Lesser-M/ECEN404-Team-30--Autonomous-lawnmower/Reports-404/Individual Reports/5-3 404 Schedule.pdf

# Execution Plan for Autonomous Lawnmower

Pink: Presentation Week
Entire system
Final Presentation
Final Demo
Final Report
Obstacle detection construction
Obstacle detection validated
Obstacle detection & GPS MCU validation Obstacle detection & GPS MCU integration Power Supply Testing and Validation Lawnmower Shell Deconstruction Lawnmower Shell Cleaning
Docking Station Data Collection
Docking Station Assembly
Docking Station Testing
Docking Station and Power Supply Integration Docking Station and Power Supply Testing Docking Station/Power Supply System Integration User Interface Bug Fixing
User Interface Integration, Validation
ESP32 MC Setup, Integration, & Validation Navigation subsystem design and testing Navigation subsystem integration
Motors subsystem integration
| Snow storm and power outages. Limited/No ablity to work on project

COLOR LEGEND
Subsystem Construction and Testing Integration
System Validation
Presentations/Reports
1/19/2021 | 1/26/2021 | 2/2/2021 | 2/9/2021 | 2/16/2021 | 2/23/2021 | 3/2/2021 | 3/9/2021 | 3/16/2021 | 3/23/2021 | 3/30/2021 | 4/6/2021 | 4/13/2021 | 4/20/2021 | 4/27/2021
