Lesser-M/ECEN404-Team-30--Autonomous-lawnmower/Presentations&Demos/Presentations/EPS Presentation .pdf

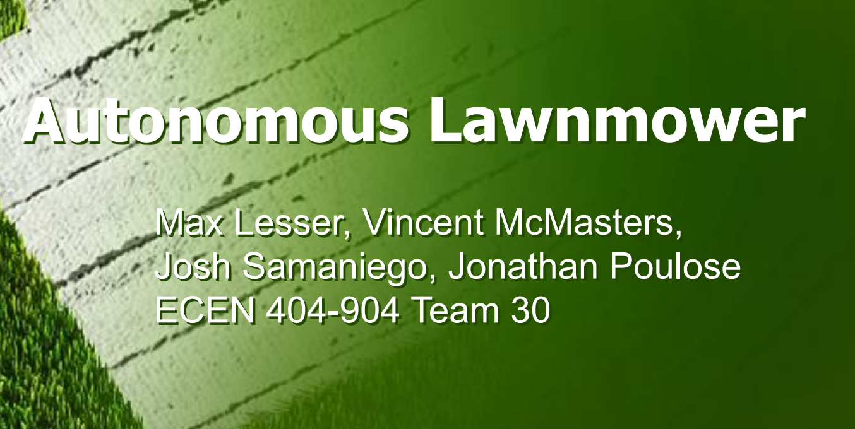
[picture p103: figure]
Autonomous Lawnmower; Max Lesser, Vincent McMasters, Josh Samaniego, Jonathan Poulose ECEN 404-904 Team 30

Project Overview

Problem Statement: “You will start with a lawn mower shell, add motors to propel the wheels, microcontroller to control everything, comms to a wifi network where area to be covered and route will be entered, and a power mechanism (docking station or other)” -
Sponsored by Prof Kalafatis

Solution approach : “We took a used lawn mower, stripped it of all its original parts, mounted motors, wheels, controllers, and sensors. We encountered many mechanical problems and had to rebuild large parts of the project in very short time, so sadly we did not get as far as we had hoped”

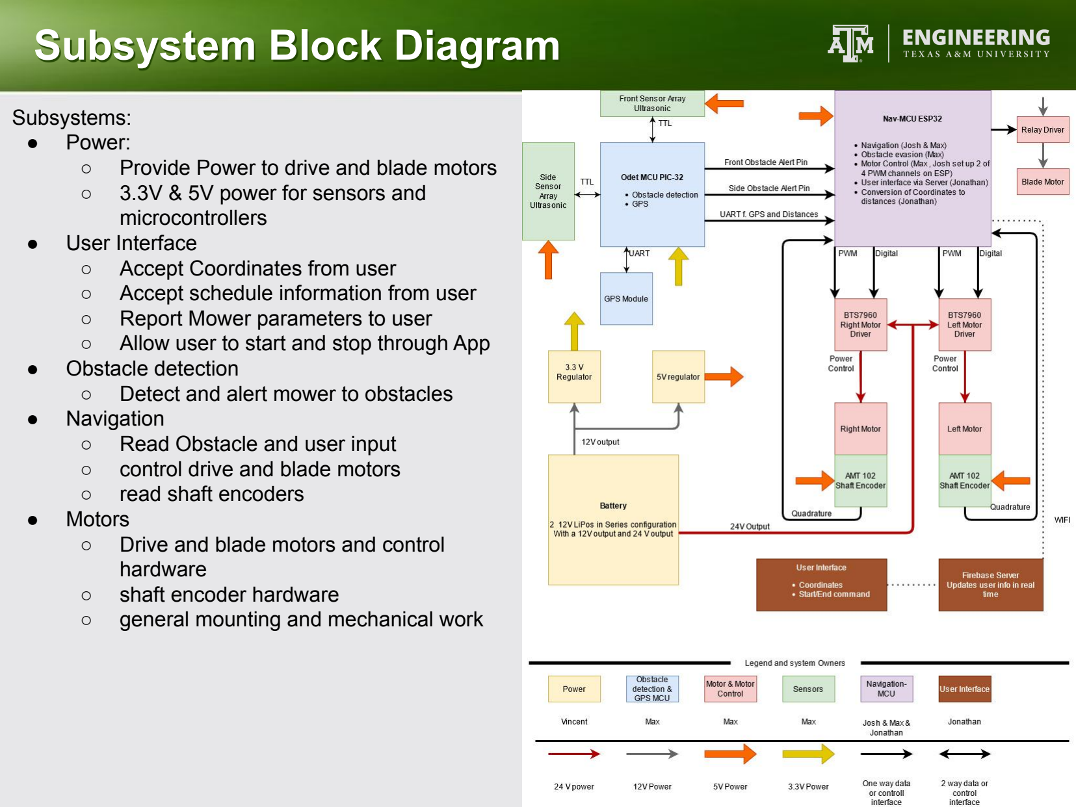
[picture p104: page 3]

Subsystem Block Diagram

Subsystems:
- Power:
- Provide Power to drive and blade motors
- 3.3V & 5V power for sensors and microcontrollers
- User Interface
- Accept Coordinates from user
- Accept schedule information from user
- Report Mower parameters to user
- Allow user to start and stop through App
- Obstacle detection
- Detect and alert mower to obstacles
- Navigation
- Read Obstacle and user input
- control drive and blade motors
- read shaft encoders
- Motors
- Drive and blade motors and control hardware
- shaft encoder hardware
- general mounting and mechanical work

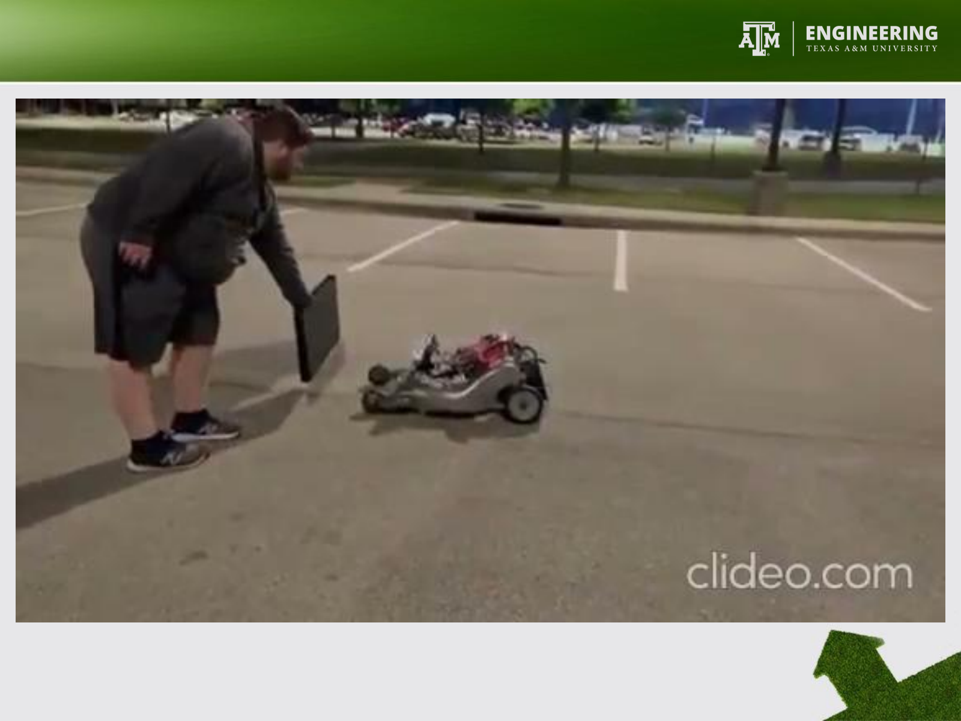
[picture p105: page 4]

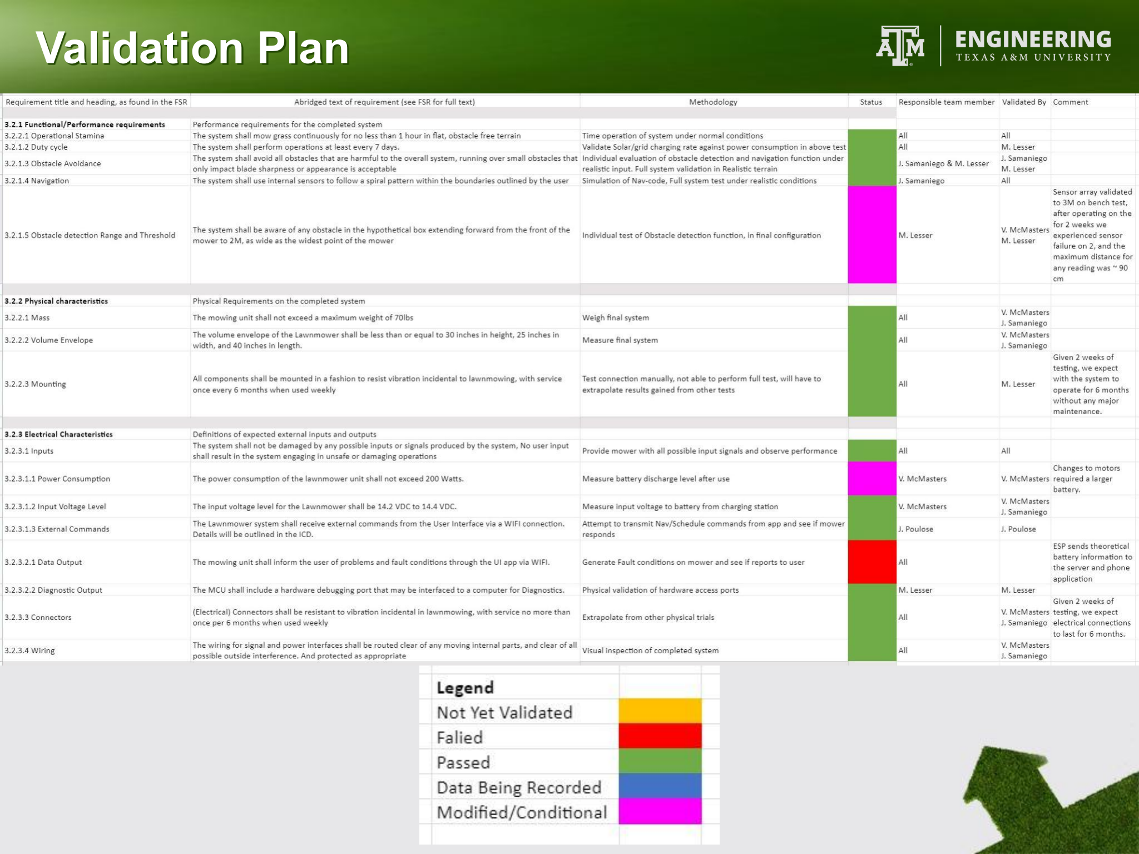
[picture p106: page 7]

Validation Plan

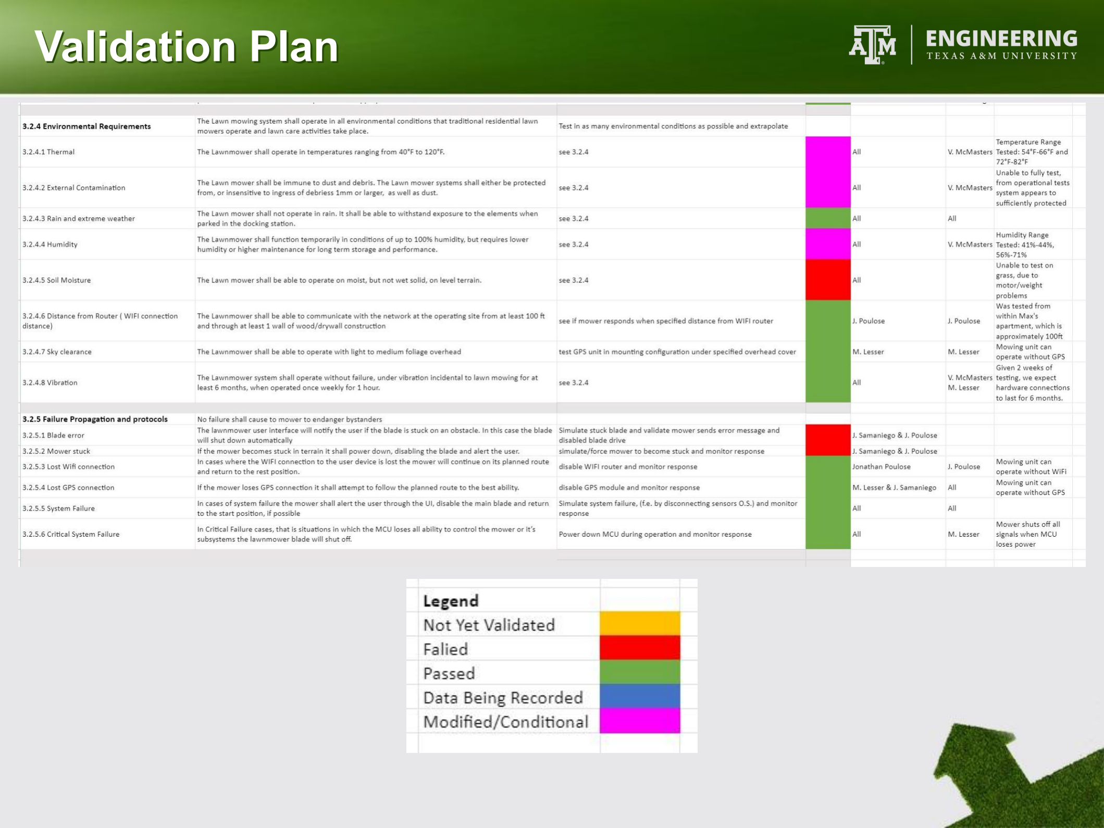
[picture p107: page 8]

Validation Plan

Issues and problems

- Late Changes to Motors
- Late changes to Power system requirements
- Late changes to Navigation system
- Hardware failure for sensors on Circuit boards
- Mechanical complications with mounting

Lessons learned

- Test early, test often
- don’t have faith, validate
- ask for help
- Express clear expectations, and measure progress against them.
- Changing Canoes in the middle of a river is bad, but if you have to, do it before you take on too much water.

Conclusion

Our project came slightly short of the finish line, as we had to address a lot of issues at the very end. Given just marginally more time we believe we could have pulled it all together.

Nonetheless, we all learned a lot. And we’re proud of the progress we’ve made.
