Lesser-M/ECEN404-Team-30--Autonomous-lawnmower/Presentations&Demos/Presentations/Biweekly Presentation 1.pdf

Autonomous Lawnmower; Max Lesser, Vincent McMasters, Josh Samaniego, Jonathan Poulose ECEN 404-904 Team 30

# Project Summary

## Problem Statement: “You will start with a lawn mower shell, add motors to propel the wheels, microcontroller to control everything, comms to a wifi network where area to be covered and route will be entered, and a power mechanism (docking station or other)”

## - Use lawn mower body and reconfigure for our needs - Electric motors for wheel and blade - Solar and grid tied charging - Docking station - Navigate autonomously using various sensors - Receive user information about area to mow and scheduling through app

# Problems and Solutions

## Problems:

- Obstacle detection issues
- Insufficient sensors
- PCB miss print
- Damaged IC
- Insufficient IO lines
- Lost design files
- Low budget

## Solutions:

- Multi MCU approach
- allows multiple team members to develop and test simultaneously
- removes wait time for PCB respin
- Includes all needed functionality
- Shifting responsibility
- Max takes over obstacle detection from sensor subsystem
- Jonathan takes over WIFI from MCU subsystem
- Vincent begins disassembling mower body now, so that it’s integration ready when other subsystems are

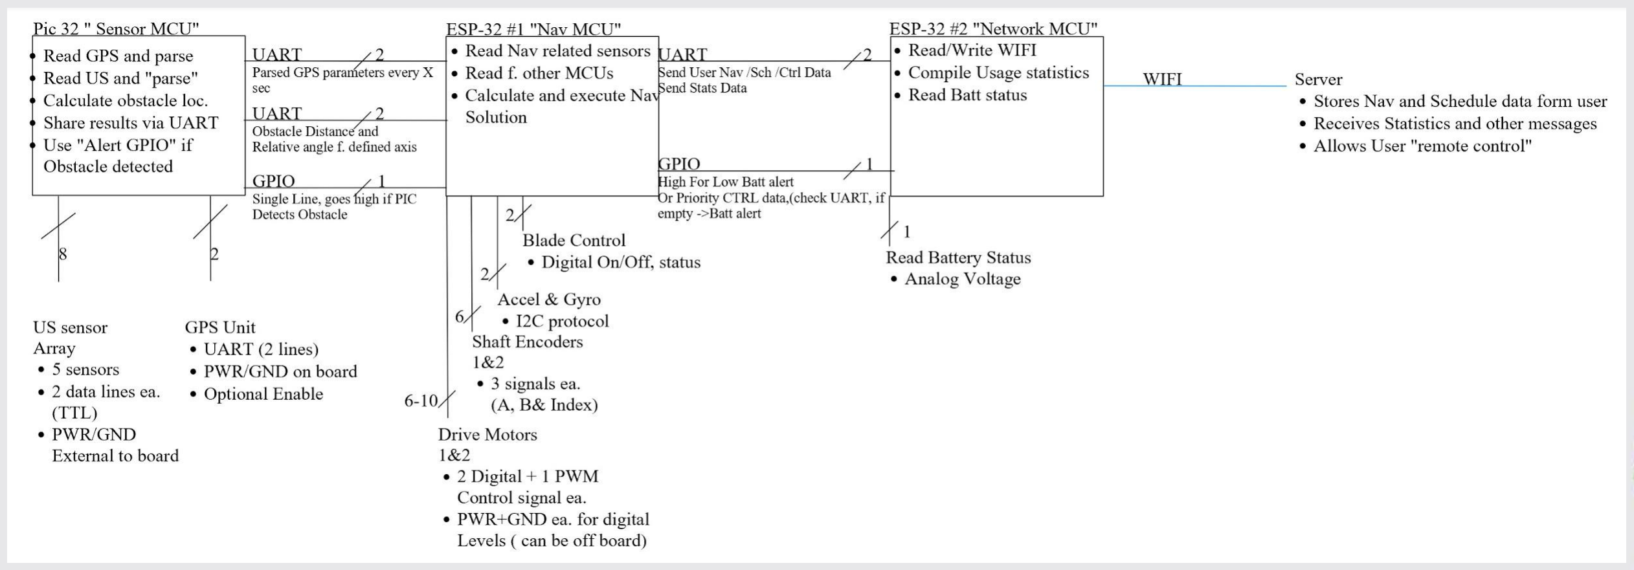
[picture p108: figure]

# MCU Subsystem

# Status and Plans

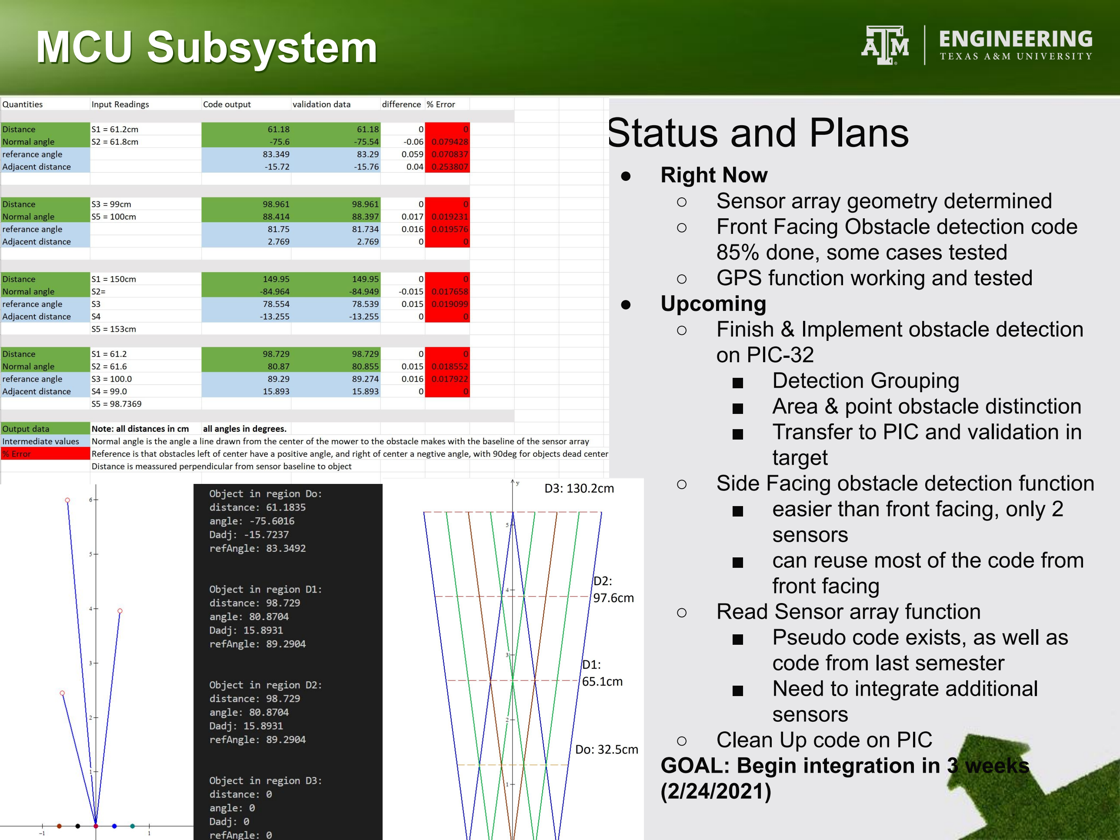
[picture p109: page 4]

- Right Now
- Sensor array geometry determined
- Front Facing Obstacle detection code 85% done, some cases tested
- GPS function working and tested
- Upcoming
- Finish & Implement obstacle detection on PIC-32
■ | Detection Grouping
■ | Area & point obstacle distinction
■ | Transfer to PIC and validation in
| target
- Side Facing obstacle detection function
■ | easier than front facing, only 2
| sensors
■ | can reuse most of the code from
| front facing
- Read Sensor array function
■ | Pseudo code exists, as well as
| code from last semester
■ | Need to integrate additional
| sensors
- Clean Up code on PIC
- GOAL: Begin integration in 3 weeks (2/24/2021)

# User Interface Update

## Android Application

- Coded in Java through android studio
- Updates to server in realtime
- User can login through google account
- Access current location
- Set markers for each corner of lawn
- Custom lawns
- Statistics
- Schedule Information

## Problems-currently fixing

- Bugs
- Getting statistics and scheduling information to communicate with server

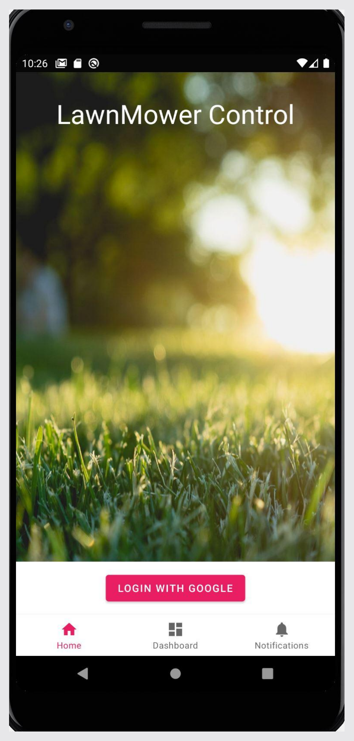
[picture p110: figure]
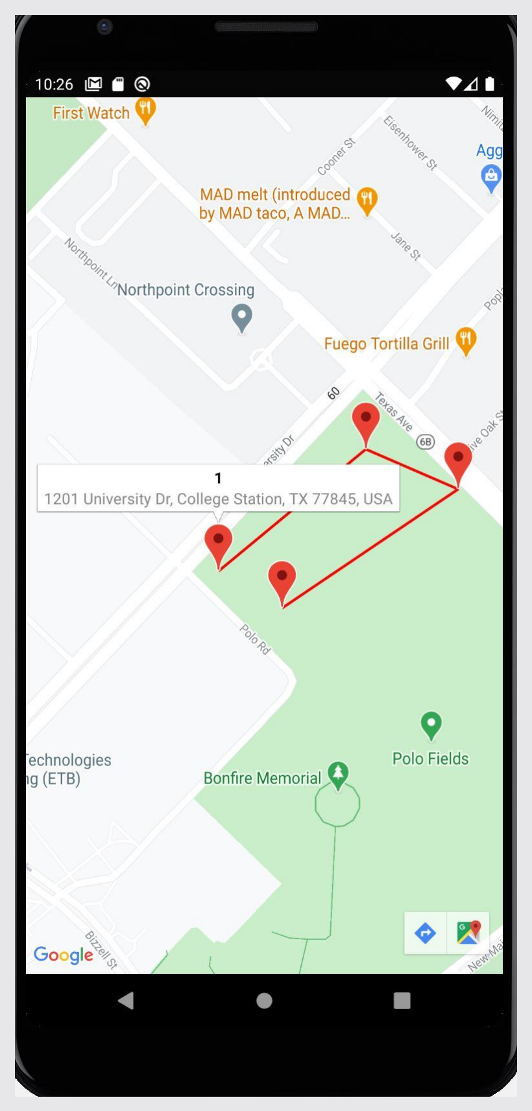
[picture p111: figure]
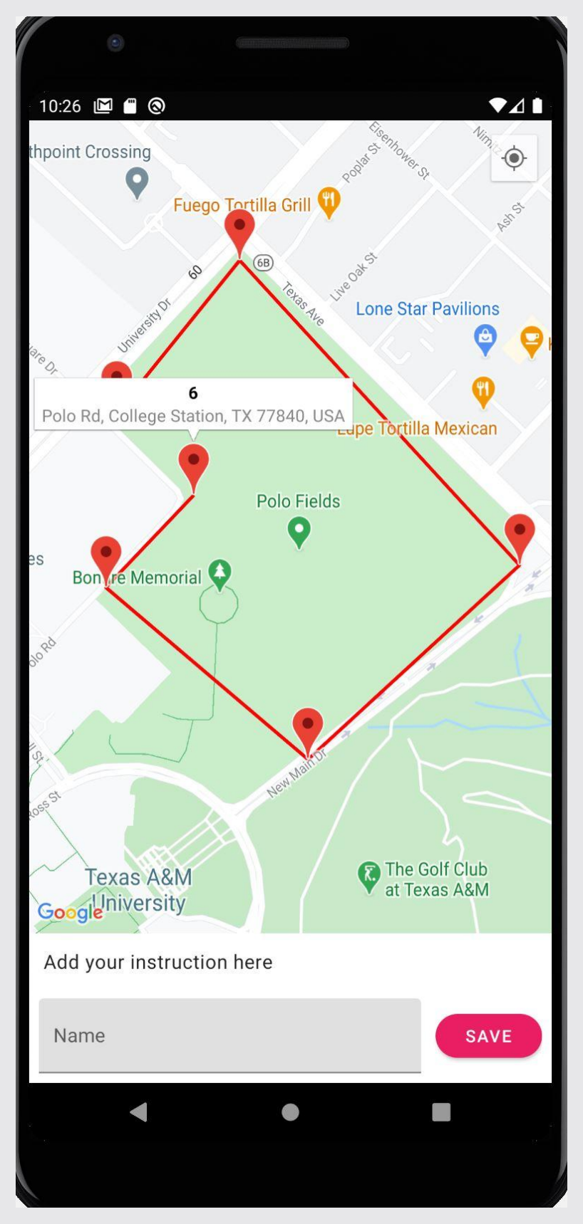
[picture p112: figure]
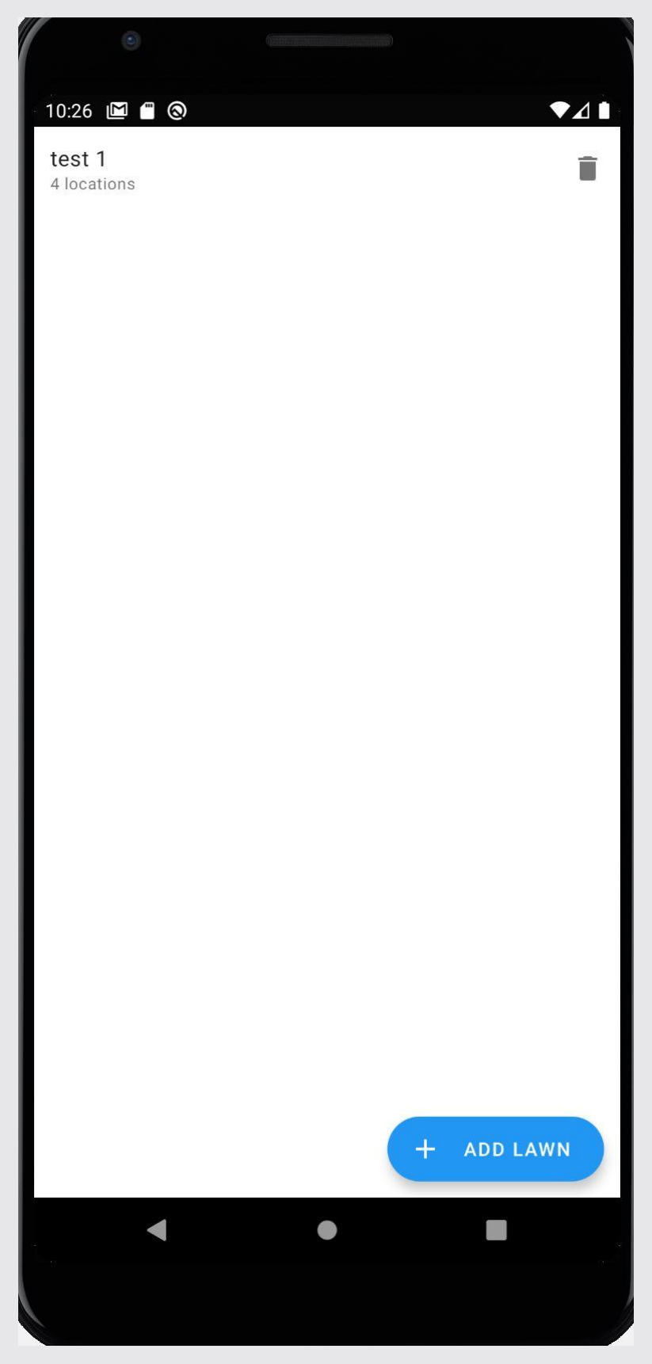
[picture p113: figure]

# Server Update

## Google Firebase Realtime Database

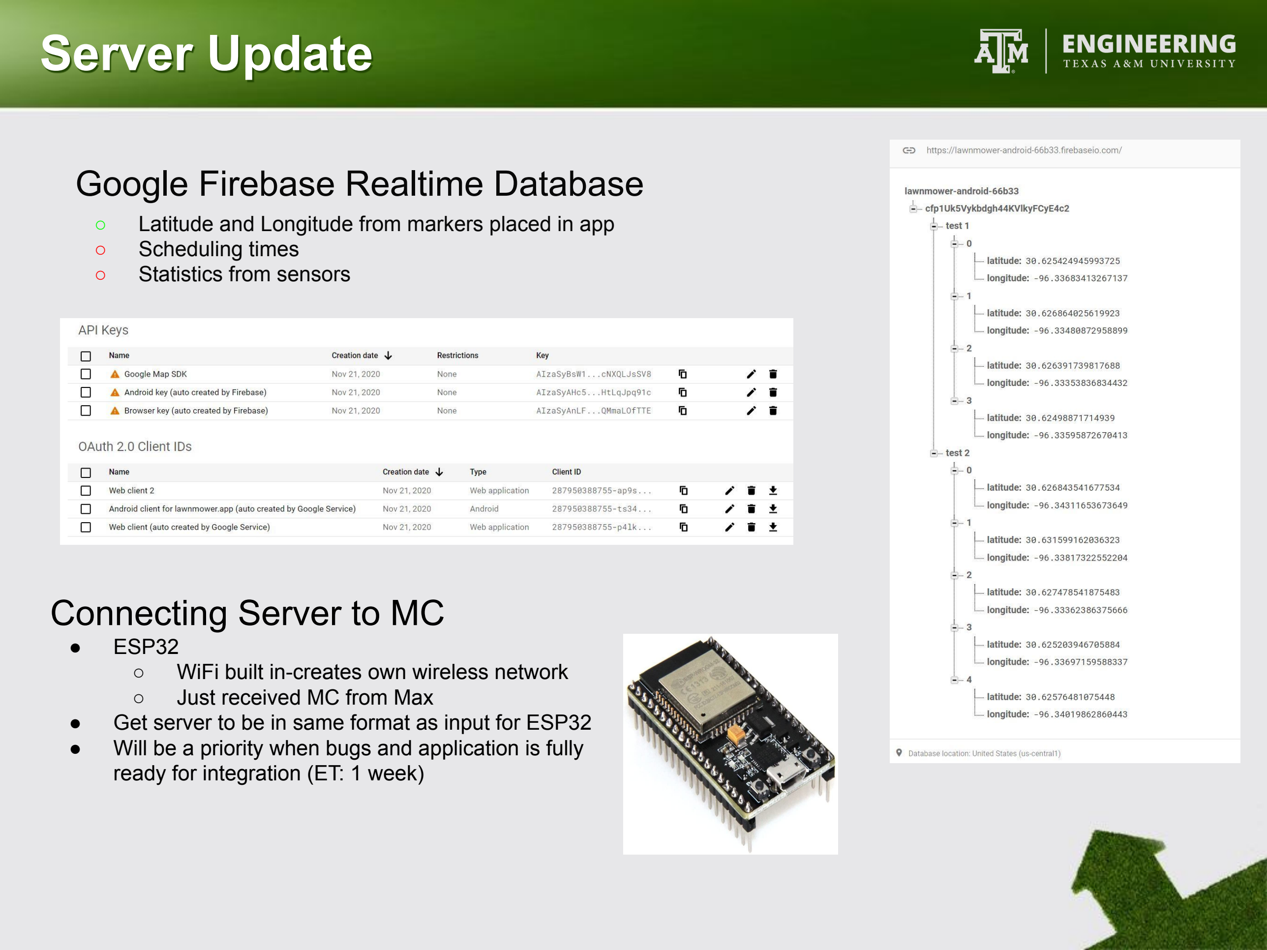
[picture p114: page 6]

- Latitude and Longitude from markers placed in app
- Scheduling times
- Statistics from sensors

## Connecting Server to MC

- ESP32
- WiFi built in-creates own wireless network
- Just received MC from Max
- Get server to be in same format as input for ESP32
- Will be a priority when bugs and application is fully ready for integration (ET: 1 week)

# Power Supply Subsystem Status

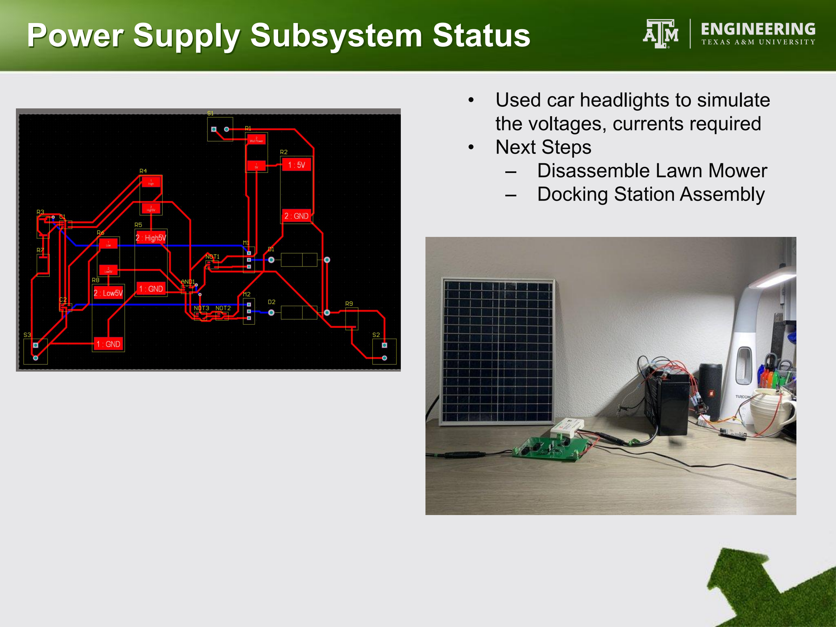
[picture p115: page 7]

### - Used car headlights to simulate the voltages, currents required - Next Steps – Disassemble Lawn Mower – Docking Station Assembly

# Motors Subsystem Status

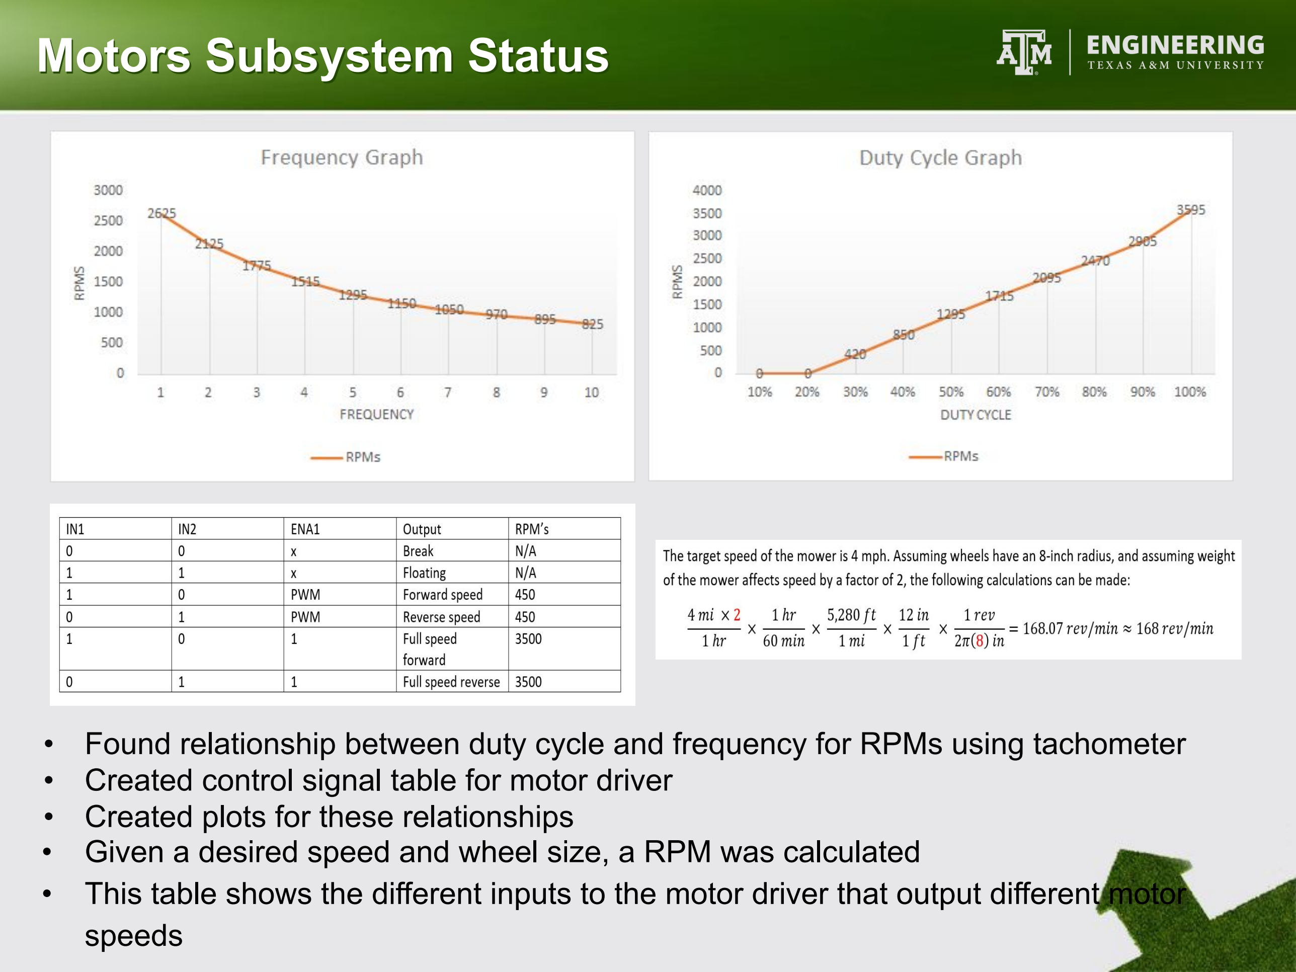
[picture p116: page 8]

- Found relationship between duty cycle and frequency for RPMs using tachometer - Created control signal table for motor driver - Created plots for these relationships - Given a desired speed and wheel size, a RPM was calculated - This table shows the different inputs to the motor driver that output different motor speeds

# Navigation Subsystem Update

## •Original design used GPS module for navigation measurements

## •Testing over the holidays revealed that 10-ft GPS “wander” error is not accurate enough for an “unmanned blade on the run”

## •New design uses individual left and right wheel shaft encoders as primary measurement

## •Some new math was needed to translate the wheel encoder measurements to the correct position and heading of the mower (rigid body constraint)

## •A new Matlab simulation movie will be presented here to demonstrate the recent changes

### Turning is initiated by the controller adjusting the relative speed of the right and left wheel motors

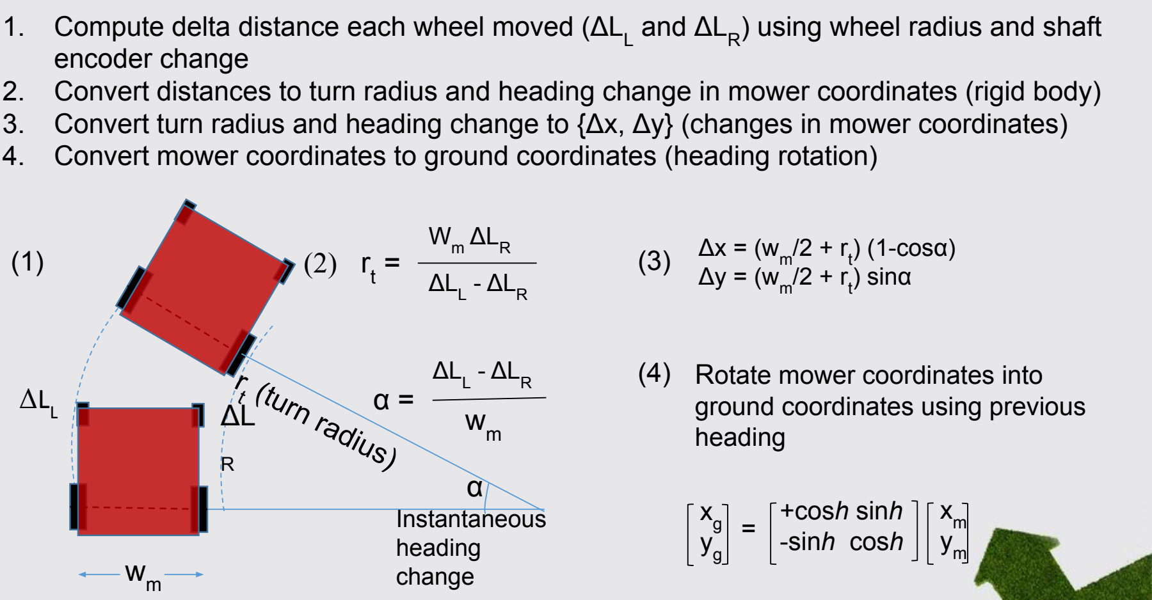
[picture p117: figure]
and ΔLR; ) using wheel radius and shaft; encoder change; ΔLR; ΔLL; - ΔLR; ) (1-cosα); ) sinα (3); (4) Rotate mower coordinates into ground coordinates using previous heading; (turn radius); Instantaneous heading change; +cosh sinh -sinh cosh

### 1. Compute delta distance each wheel moved (ΔLL

### 2. Convert distances to turn radius and heading change in mower coordinates (rigid body) 3. Convert turn radius and heading change to {Δx, Δy} (changes in mower coordinates) 4. Convert mower coordinates to ground coordinates (heading rotation)

# Simulation Updates Using Navigation Updates

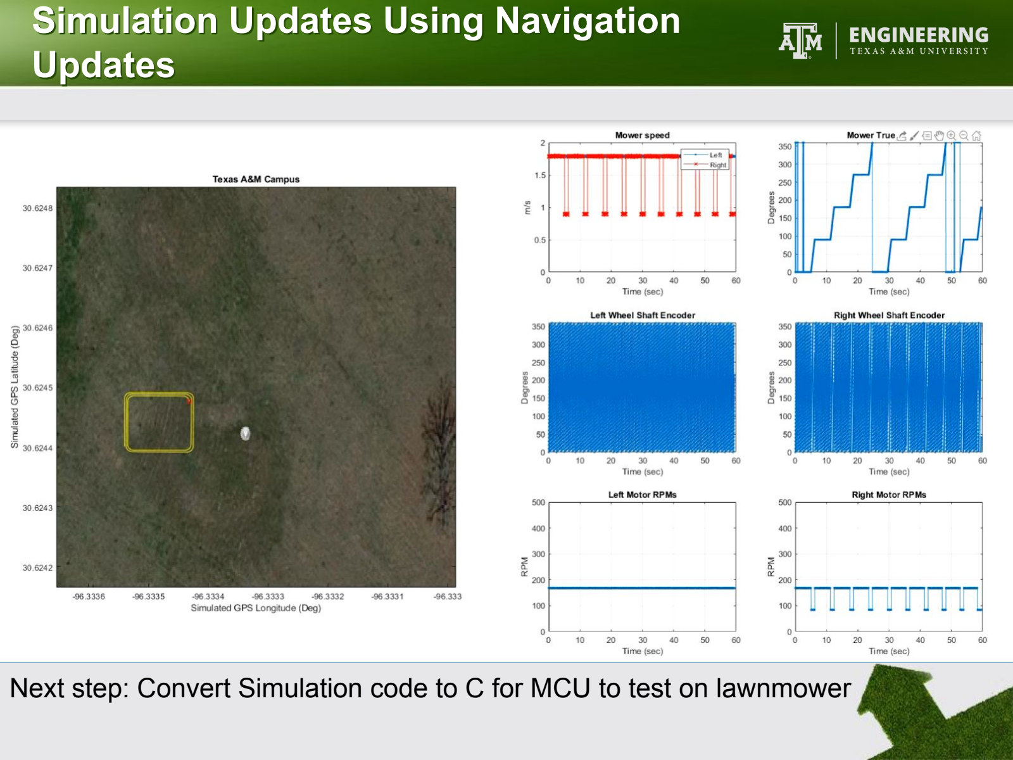
[picture p118: page 11]

## Next step: Convert Simulation code to C for MCU to test on lawnmower

# Schedule for the Semester

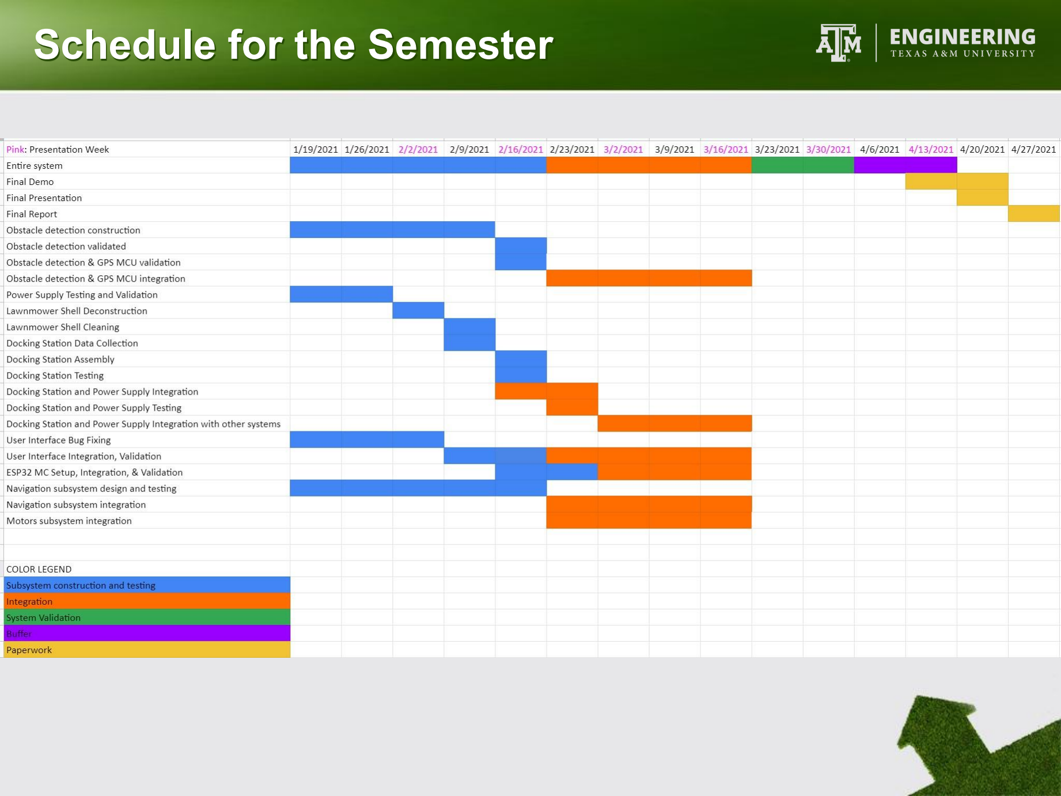
[picture p119: page 12]

# Validation Plan

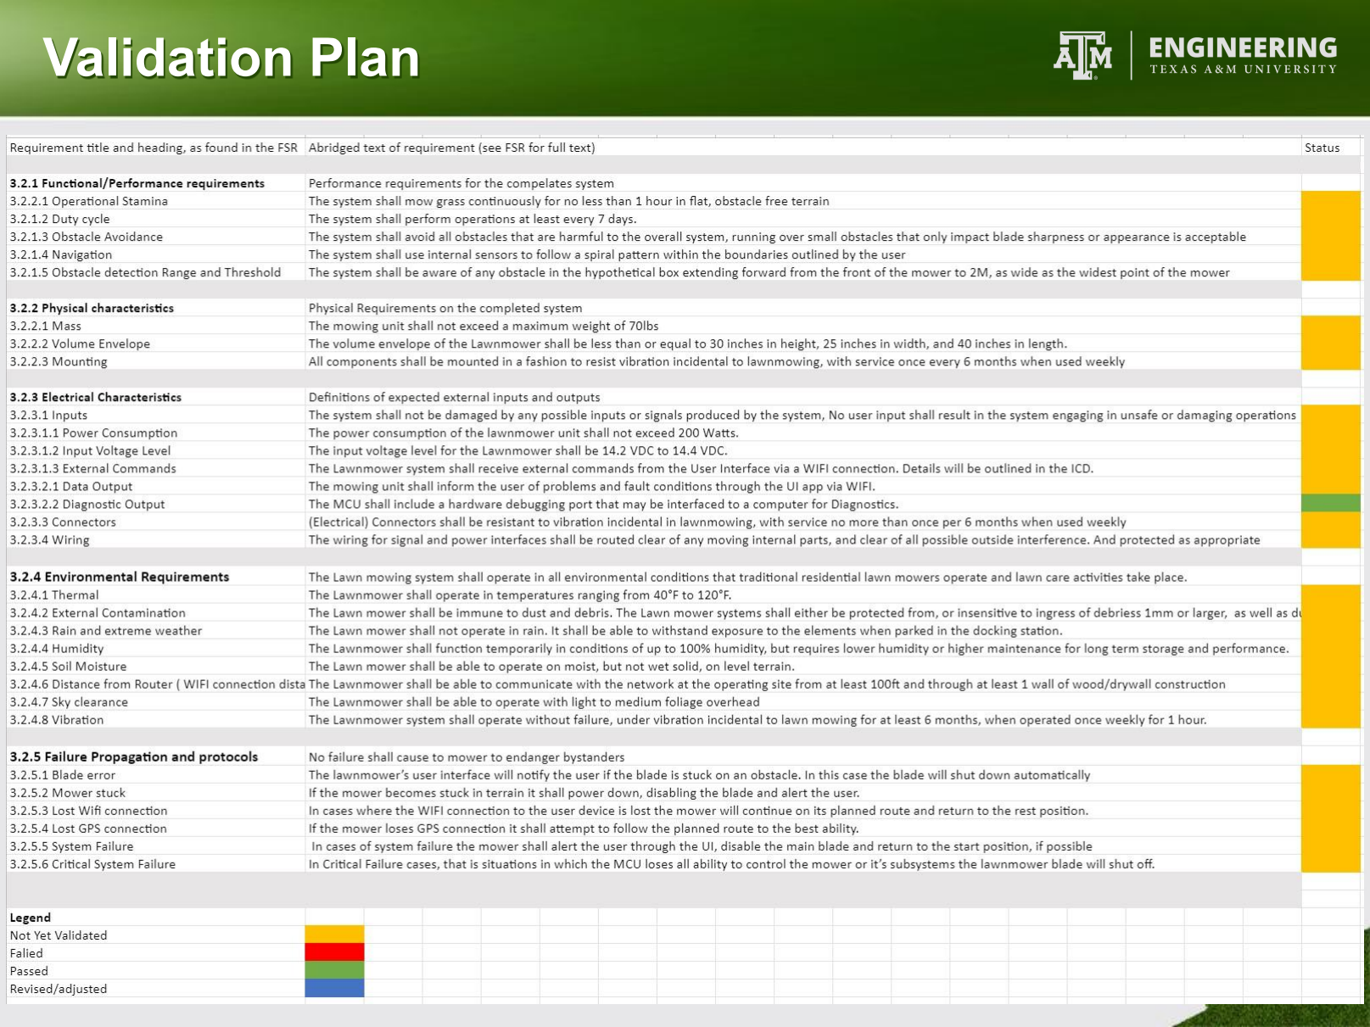
[picture p120: page 13]
