Lesser-M/ECEN404-Team-30--Autonomous-lawnmower/Presentations&Demos/Presentations/Biweekly Presentation 2.pdf

Autonomous Lawnmower; Max Lesser, Vincent McMasters, Josh Samaniego, Jonathan Poulose ECEN 404-904 Team 30

# Project Summary

## Problem Statement: “You will start with a lawn mower shell, add motors to propel the wheels, microcontroller to control everything, comms to a wifi network where area to be covered and route will be entered, and a power mechanism (docking station or other)”

## - Use lawn mower body and reconfigure for our needs - Electric motors for wheel and blade - Solar and grid tied charging - Docking station - Navigate autonomously using various sensors - Receive user information about area to mow and scheduling through app

# Problems and Solutions

## Problems (looking towards interfacing):

- Front Mower wheels 0-degree turn
- Rear Mower wheels
- Geared connection/transmission
- Solid axle
- Blade drive attachment
- How to mount blade motor
- MCU interface
- US sensors have issues detecting object with fabric
- Readings for objects covered in fabric (f.e. person wearing sweatshirt) extremely inaccurate and unreliable

## Solutions:

- Caster wheels in the front
- Allows 0-degree turn
- Several Options for rear
- Cut axel in 2 parts and mount motors to that, adjust for gearing ratio in code
- Manufacture shaft and mount directly to wheels and motors for 1:1 ratio. (Need to ensure sufficient torque, but ratio stays the same, possibly easier motor mounting because the old shaft won’t be in the way)
- Several Options for Blade also
- Disassemble motor and reuse its driveshaft
- Manufacture our own driveshaft
- MCU interface
- Need to finalize format
- Person detection
- Include Bump/contact sensor in front
- More extensive tests with full array, may be possible to determine fabric with multiple sensors.

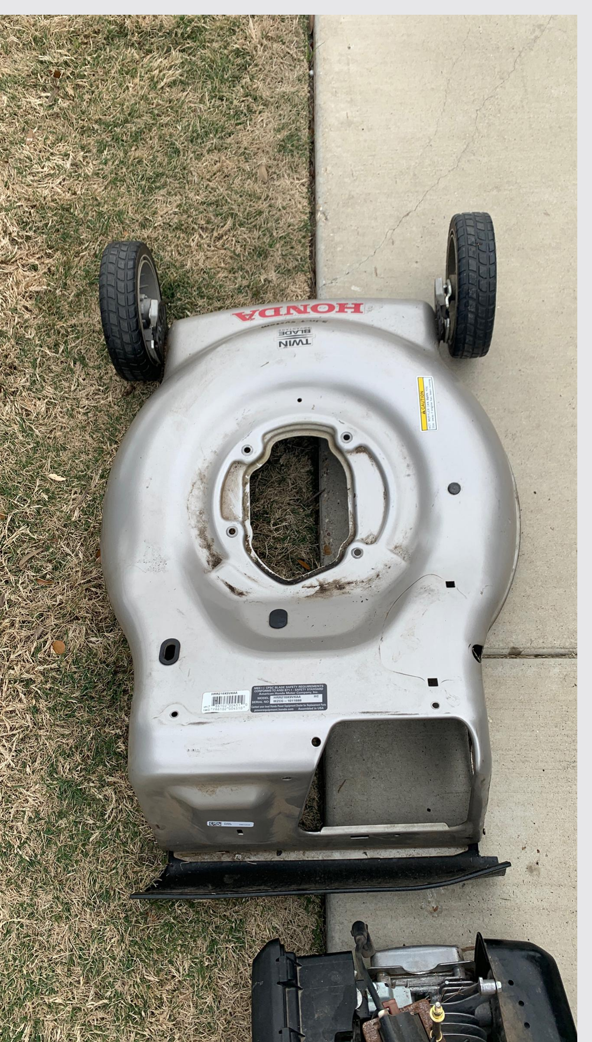
[picture p121: figure]

# MCU Subsystem (Obstacle detection)

# Status and Plans

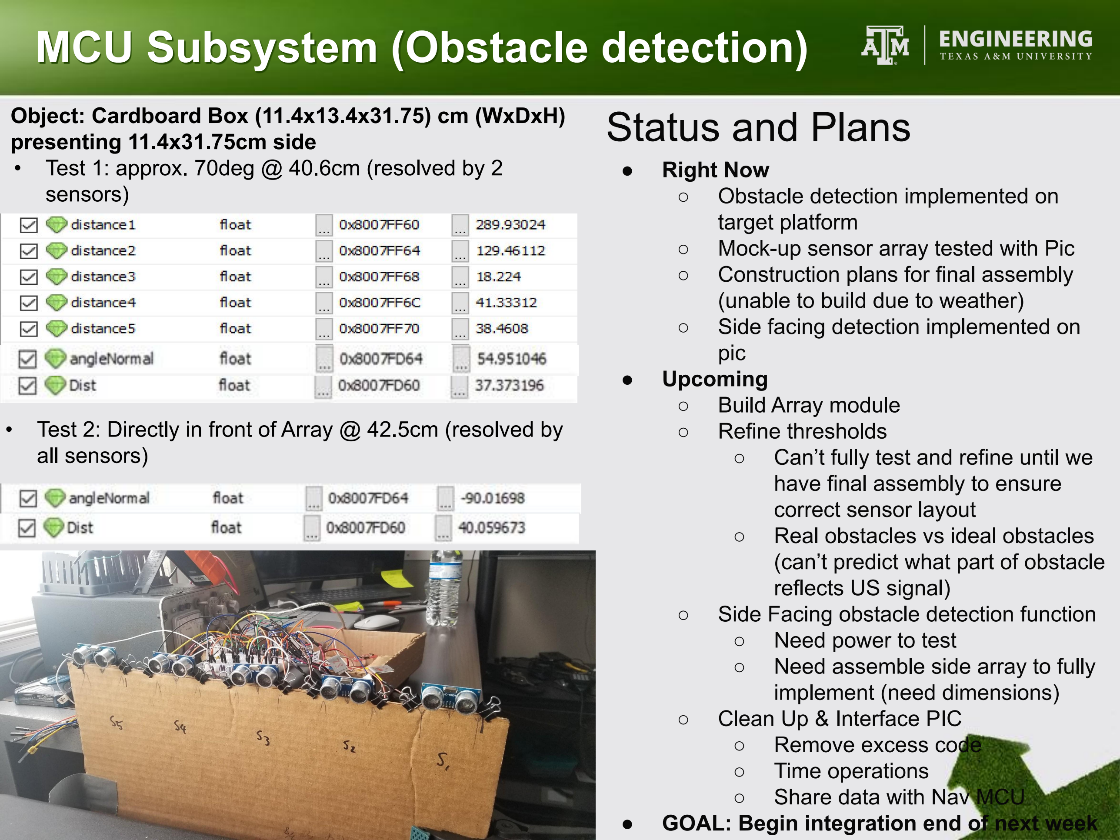
[picture p122: page 4]

- Right Now
- Obstacle detection implemented on target platform
- Mock-up sensor array tested with Pic
- Construction plans for final assembly (unable to build due to weather)
- Side facing detection implemented on pic
- Upcoming
- Build Array module
- Refine thresholds
- Can’t fully test and refine until we have final assembly to ensure correct sensor layout
- Real obstacles vs ideal obstacles (can’t predict what part of obstacle reflects US signal)
- Side Facing obstacle detection function
- Need power to test
- Need assemble side array to fully implement (need dimensions)
- Clean Up & Interface PIC
- Remove excess code
- Time operations
- Share data with Nav MCU
- GOAL: Begin integration end of next week
- Test 2: Directly in front of Array @ 42.5cm (resolved by all sensors)

Object: Cardboard Box (11.4x13.4x31.75) cm (WxDxH) presenting 11.4x31.75cm side
- Test 1: approx. 70deg @ 40.6cm (resolved by 2 sensors)

# User Interface/Server Update

# -Bugs all fixed

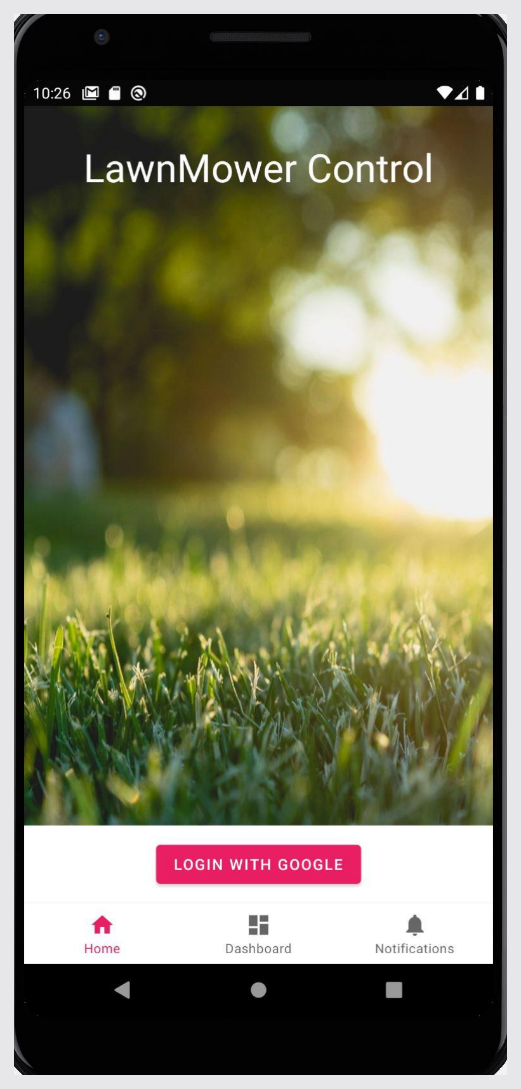
[picture p123: figure]

# -Scheduling times -Start & “Go home to docking station” successfully implemented through the firebase server -Ready to receive statistics

# WiFi Update

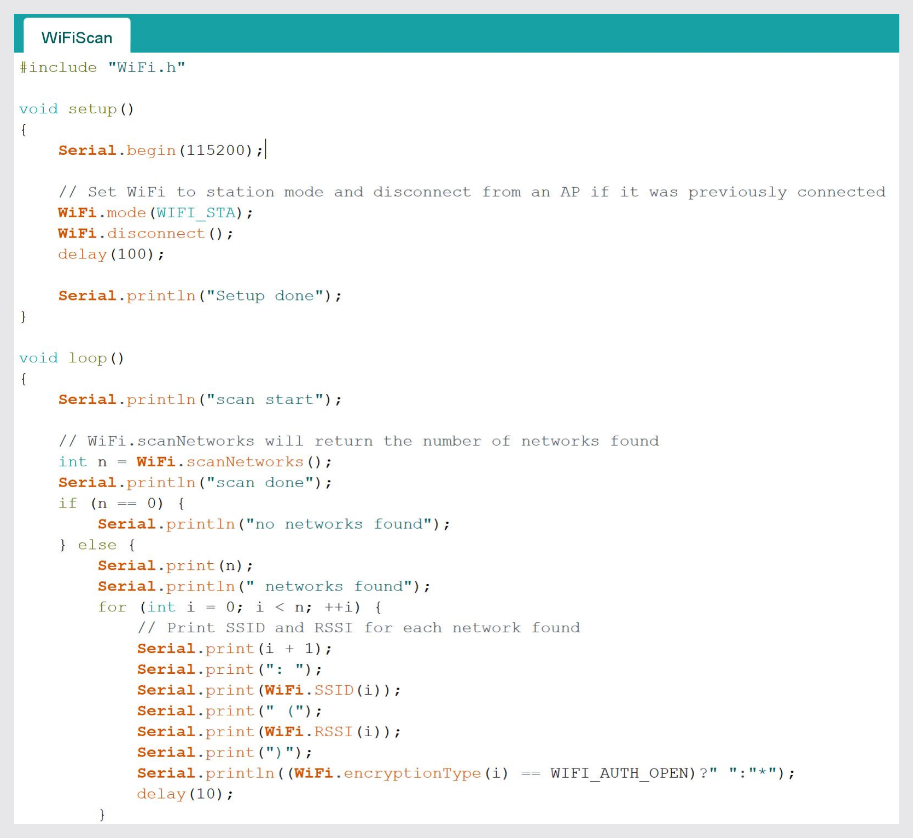
[picture p124: figure]

# - Using ESP32 DEVKIT V1 - Ran WiFiScan program

# – Set up as STA mode

# - Ran WiFiAccessPoint Program

# – Set up as soft access point mode

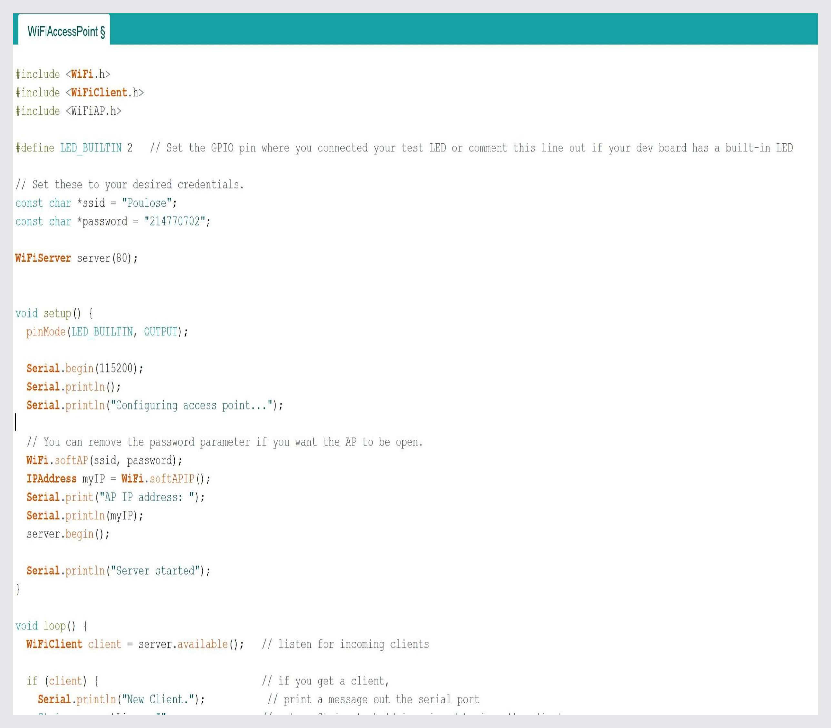
[picture p125: figure]

# - Started to write the code to be able to communicate with other ESP32

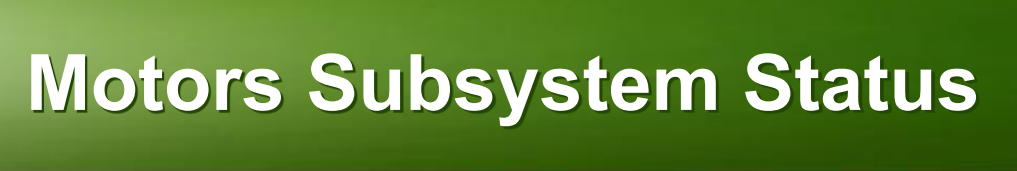
[picture p126: figure]
Motors Subsystem Status

# Motors subsystem ready to integrate

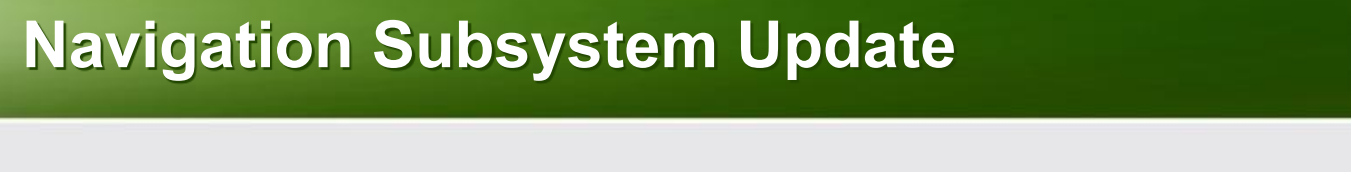
[picture p127: figure]
Navigation Subsystem Update

# - Transferred MATLAB simulation code to C - Successfully created 32 file project to run on the MCU - Working on inserting the code for it to work with real time signals from shaft encoders, PWM, and motors - Should be ready to integrate on time in reference to our schedule - Code on next slide

Navigation cont.

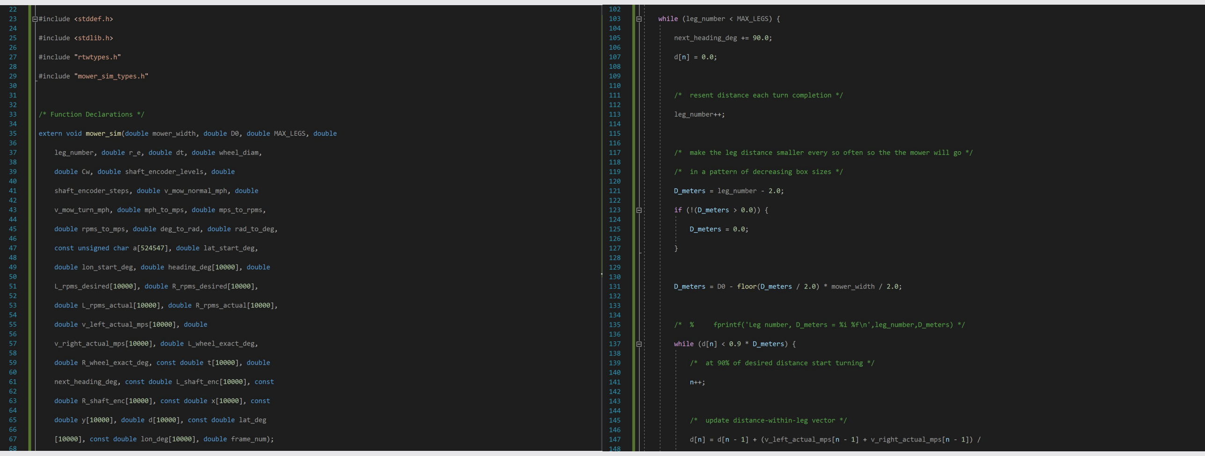
[picture p128: figure]

mower_sim.h (main function and variable initializations)

mower_sim.c (snippet of navigation code)

# Docking Station Update

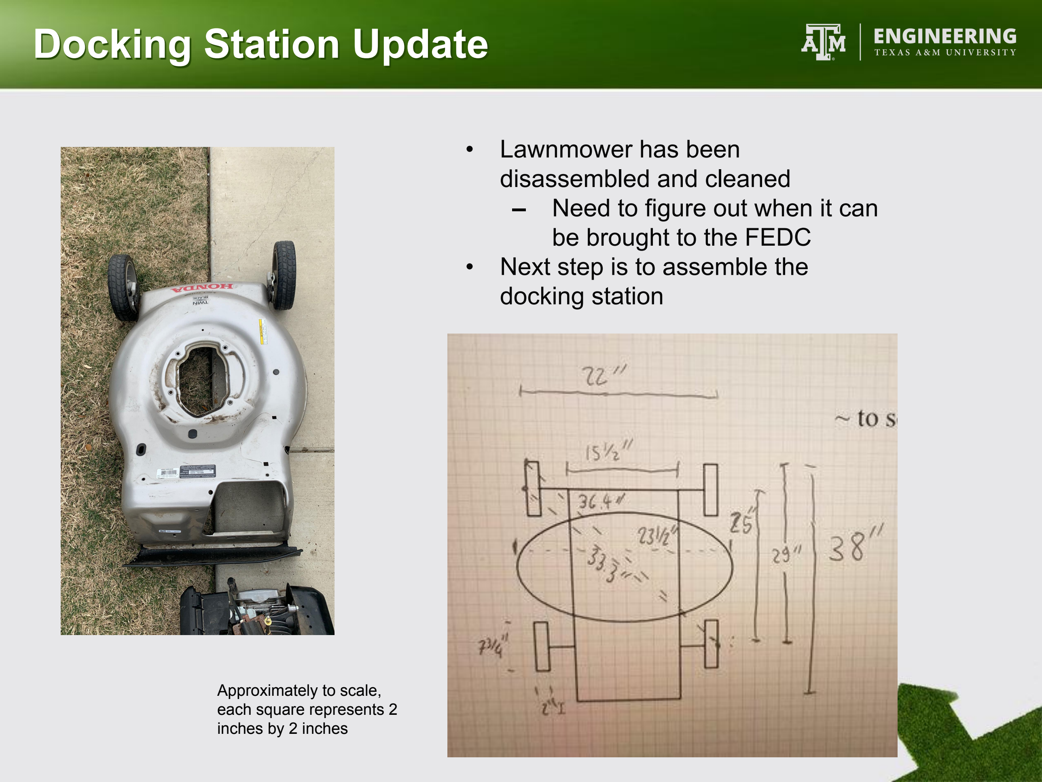
[picture p129: page 10]

### - Lawnmower has been disassembled and cleaned – Need to figure out when it can be brought to the FEDC - Next step is to assemble the docking station

Approximately to scale,
each square represents 2
inches by 2 inches

# Schedule for the Semester

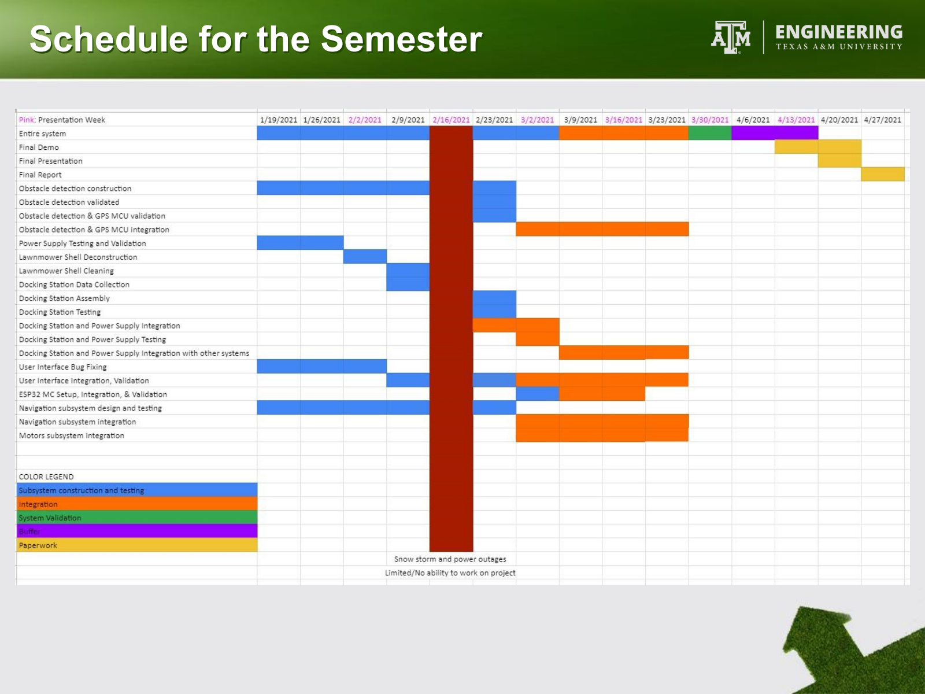
[picture p130: page 11]

# Validation Plan

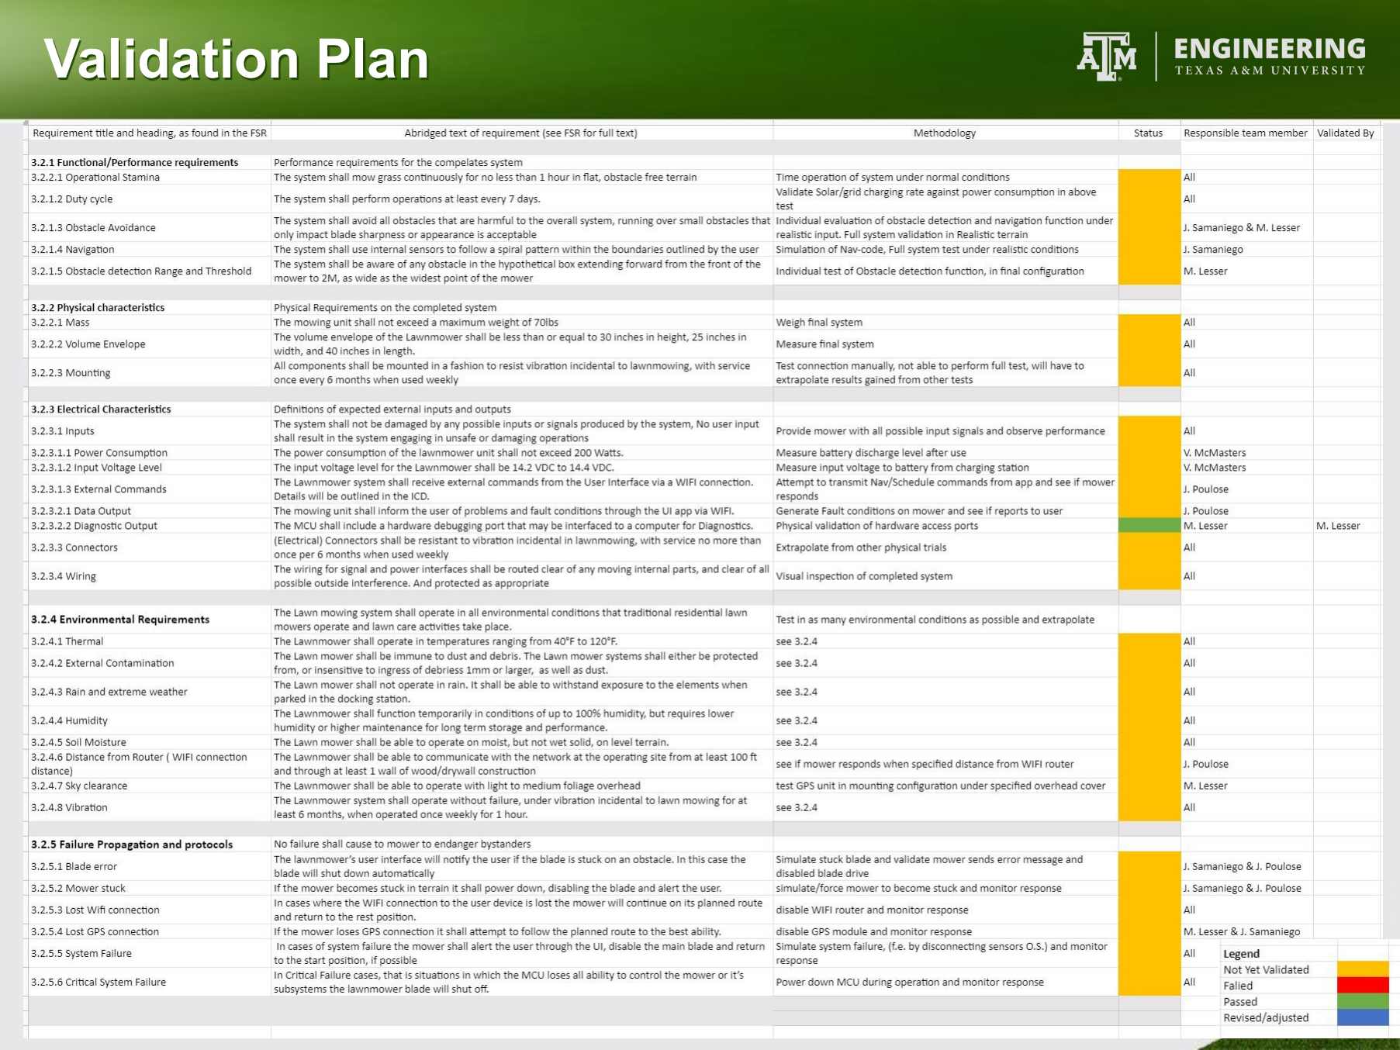
[picture p131: page 12]

# Video Link

## Attached here is the link to the video of our presentation:

## https://youtu.be/IHkTR2UbbH4
