Lesser-M/ECEN404-Team-30--Autonomous-lawnmower/Presentations&Demos/Presentations/Biweekly Presentation 3.pdf

Autonomous Lawnmower; Max Lesser, Vincent McMasters, Josh Samaniego, Jonathan Poulose ECEN 404-904 Team 30

# Project Summary

## Problem Statement: “You will start with a lawn mower shell, add motors to propel the wheels, microcontroller to control everything, comms to a wifi network where area to be covered and route will be entered, and a power mechanism (docking station or other)”

## - Use lawn mower body and reconfigure for our needs - Electric motors for wheel and blade - Solar and grid tied charging - Docking station - Navigate autonomously using various sensors - Receive user information about area to mow and scheduling through app

# Problems and Solutions

## Problems (looking towards interfacing):

- Attachment of major components
- MCU interface
- O-Det MCU to Nav MCU
- Nav MCU to WIFI MCU
- US sensors have issues detecting object with fabric
- Readings for objects covered in fabric (f.e. person wearing sweatshirt) extremely inaccurate and unreliable
- Whole System Start Stop Logic

## Solutions:

- Mounting of Major components: begin work next week
- MCU interface (Nav-ODet)
- UART, Comma delimited fields
- GPIO Pin to alert when obstacle is within close range
- Need to specify remaining details (<CR><LF>s, order, frequency), easily adjustable in code
- MCU interface(ODet-Network)
- Communicating through WiFi
- Using Primary and Secondary IDE Files for each each ESP32
- Person detection
- Include Bump/contact sensor in front
- More extensive tests with full array, may be possible to determine fabric with multiple sensors.
- Start-Stop
- WIFI MCU controls start/stop,
- controls PSU relay to power on/off system as needed,

# MCU Subsystem (Obstacle detection)

# Status and Plans

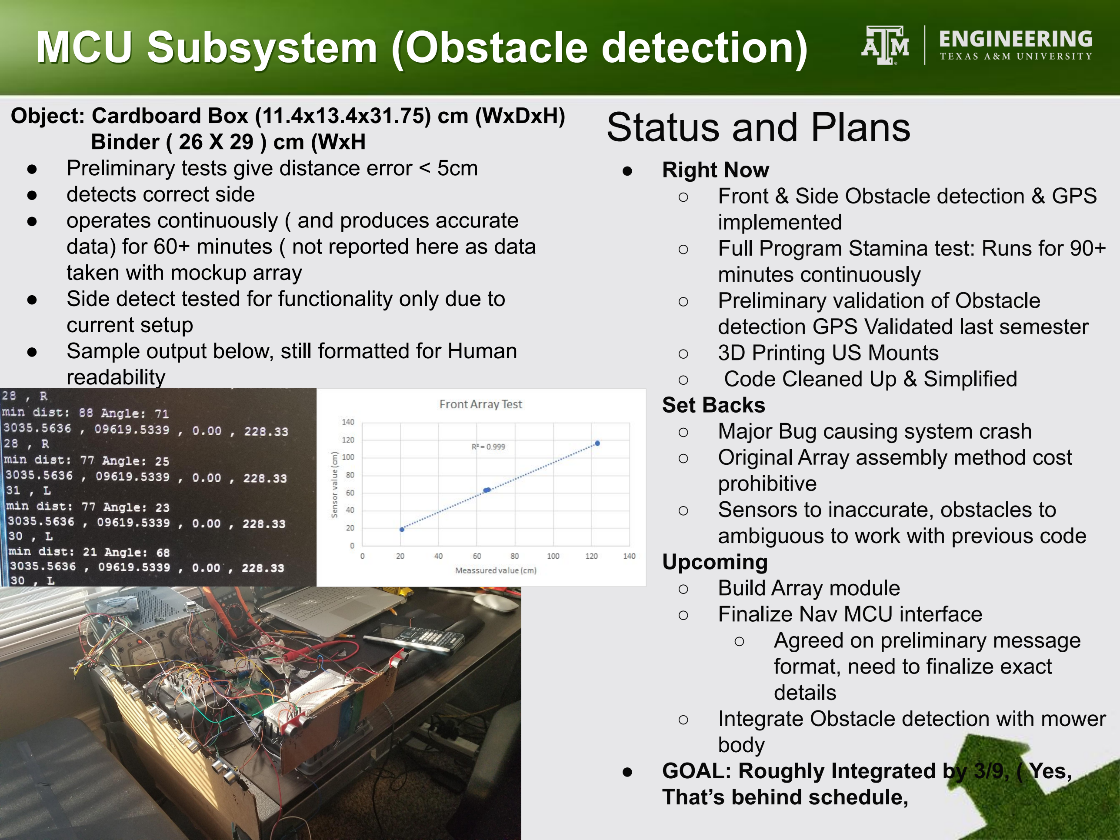
[picture p132: page 4]

- Right Now
- Front & Side Obstacle detection & GPS implemented
- Full Program Stamina test: Runs for 90+ minutes continuously
- Preliminary validation of Obstacle detection GPS Validated last semester
- 3D Printing US Mounts
- Code Cleaned Up & Simplified
- Set Backs
- Major Bug causing system crash
- Original Array assembly method cost prohibitive
- Sensors to inaccurate, obstacles to ambiguous to work with previous code
- Upcoming
- Build Array module
- Finalize Nav MCU interface
- Agreed on preliminary message format, need to finalize exact details
- Integrate Obstacle detection with mower body
- GOAL: Roughly Integrated by 3/9, ( Yes, That’s behind schedule,

Object: Cardboard Box (11.4x13.4x31.75) cm (WxDxH) Binder ( 26 X 29 ) cm (WxH
- Preliminary tests give distance error < 5cm
- detects correct side
- operates continuously ( and produces accurate data) for 60+ minutes ( not reported here as data taken with mockup array
- Side detect tested for functionality only due to current setup
- Sample output below, still formatted for Human readability

# User Interface/Server Update

# -Tested battery status

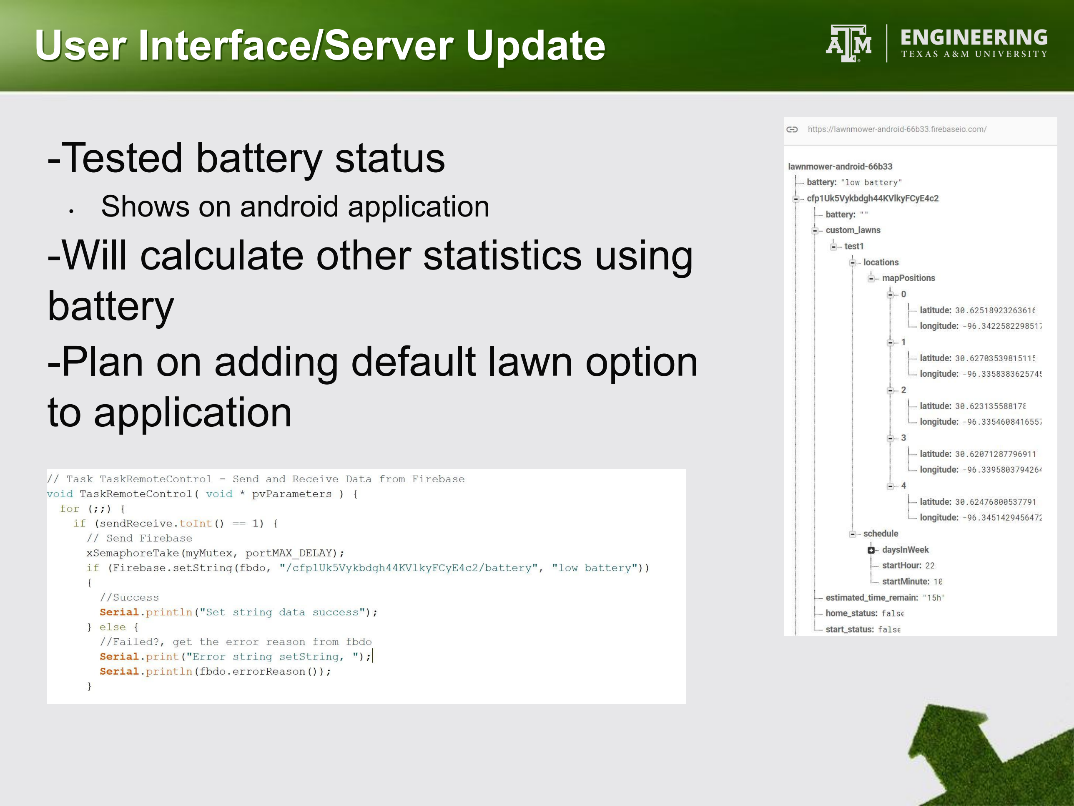
[picture p133: page 5]

## - Shows on android application

# -Will calculate other statistics using battery -Plan on adding default lawn option to application

# WiFi Update

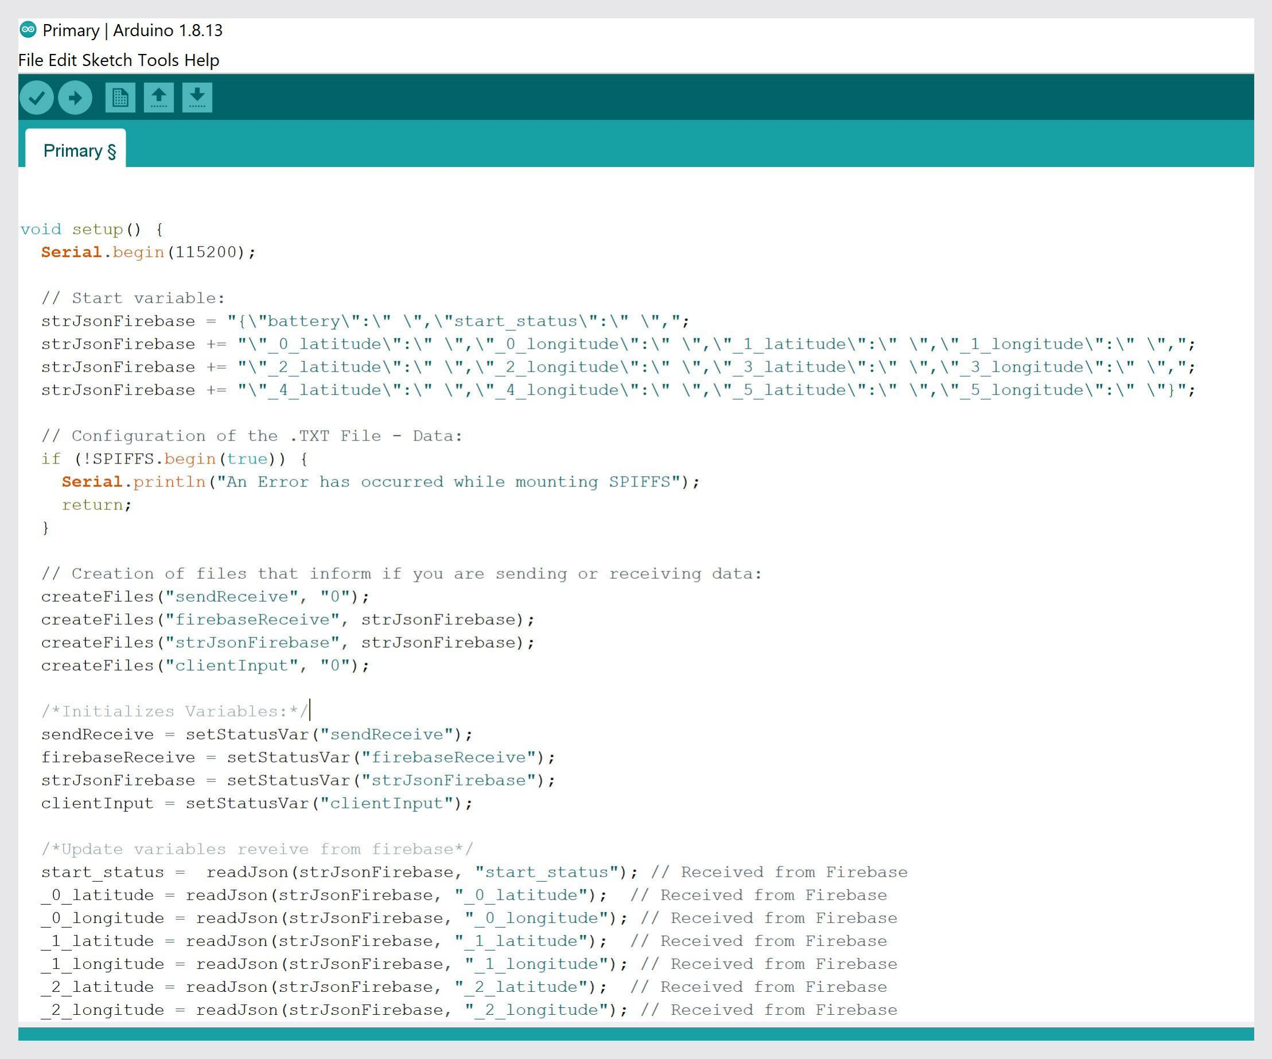
[picture p134: figure]

# - Wrote two arduino IDE files

# – Primary (ESP 32 Server) - Will be able to receive statistics – Secondary(ESP 32 ESP 32) - Tested sending coordinates

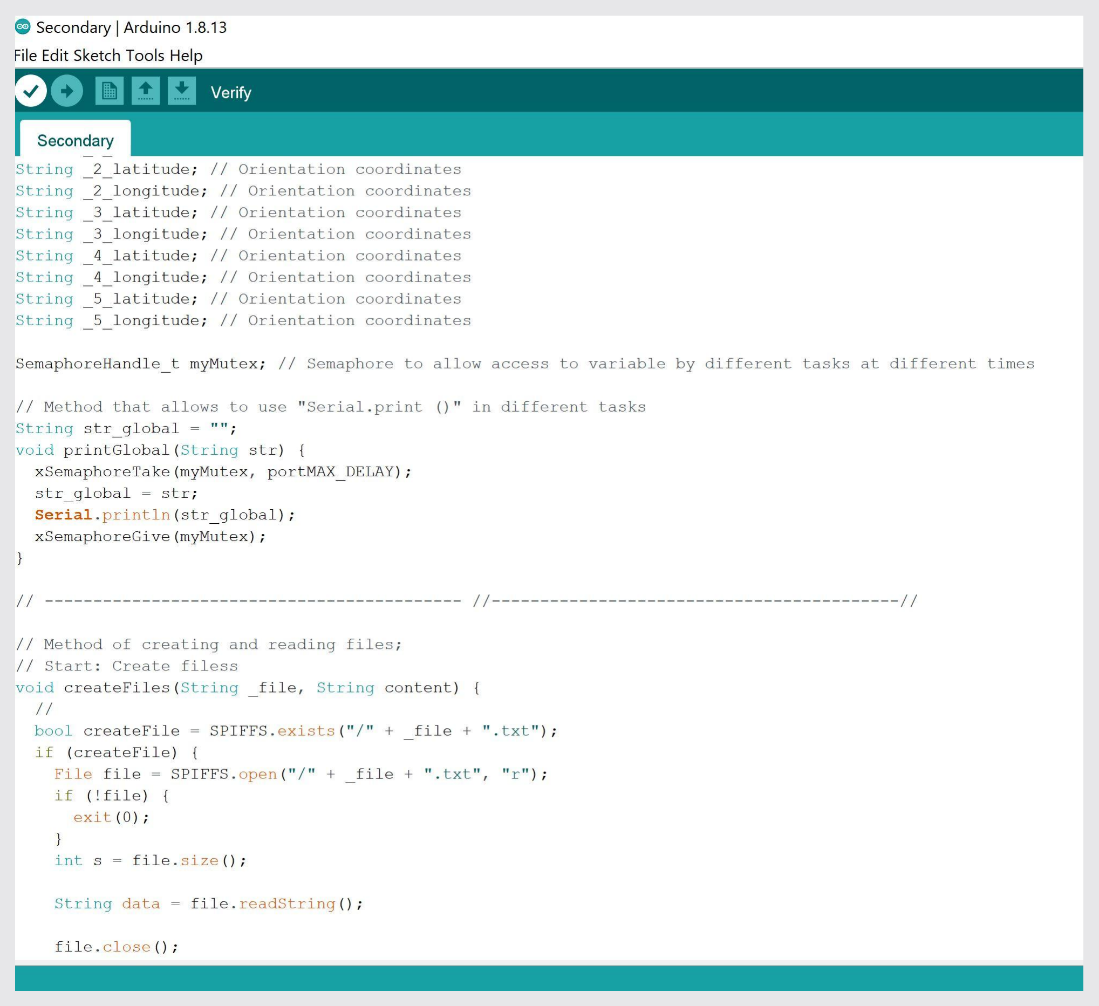
[picture p135: figure]

# - Both Microcontrollers communicate through WiFi

# - Josh, Max, and I have agreed on

coordinate format.

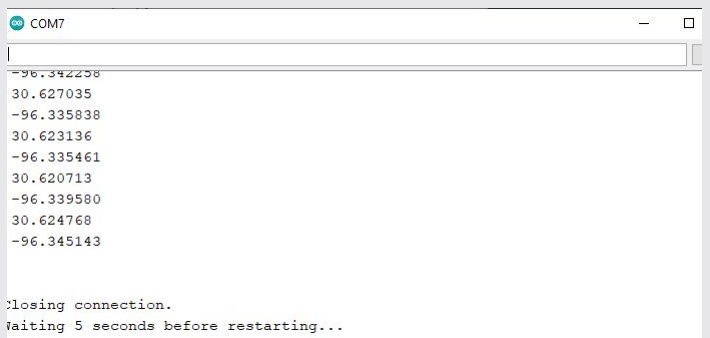
[picture p136: figure]

Motors Subsystem Status

# Motors subsystem ready to integrate

Navigation Subsystem Update

## - Setup Arduino IDE - Successfully compiled and uploaded a C test routine to control a GPIO pin on the ESP32 using LEDs - Compiled and uploaded the navigation code to the ESP32 using Arduino IDE (no errors) - Inserted software to send PWM to the motor driver via

## GPIO

## - Created code to generate a hardware interrupt and a Interrupt Service Request (ISR) so that when channel A and channel B meet certain conditions, we increment the shaft encoder counts

- Plans are to incorporate the shaft encoder interface, GPS,

## and obstacle detection to the code and run a motor test

before integration this weekend.

Navigation cont.

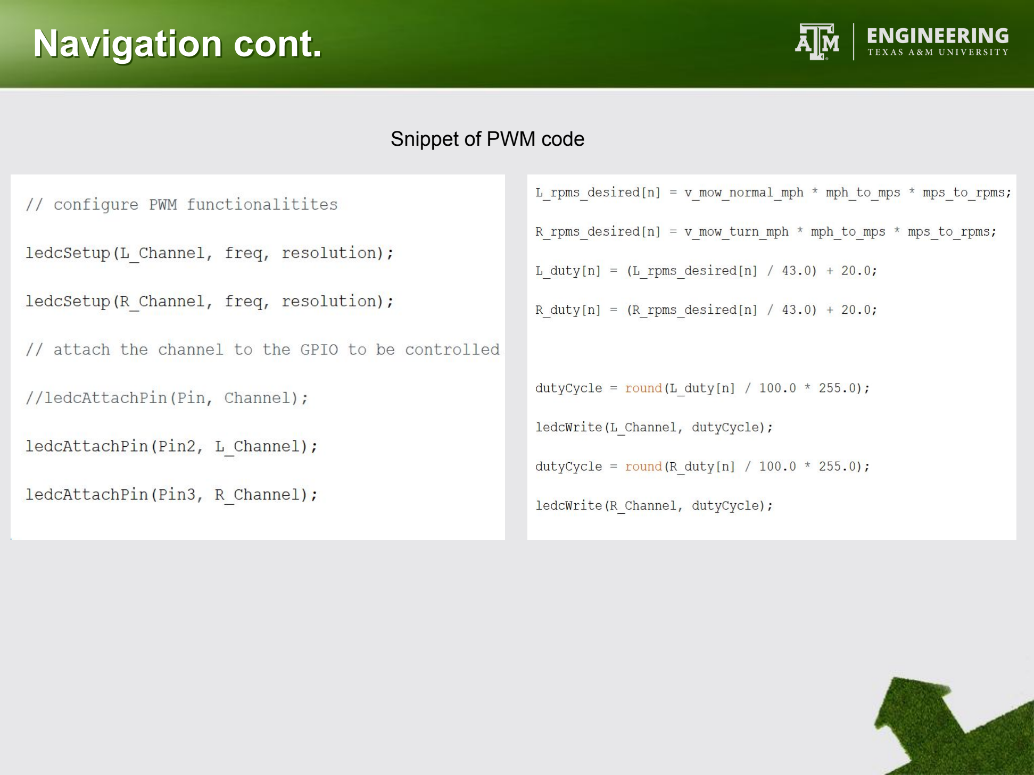
[picture p137: page 9]

Snippet of PWM code

# Docking Station Update

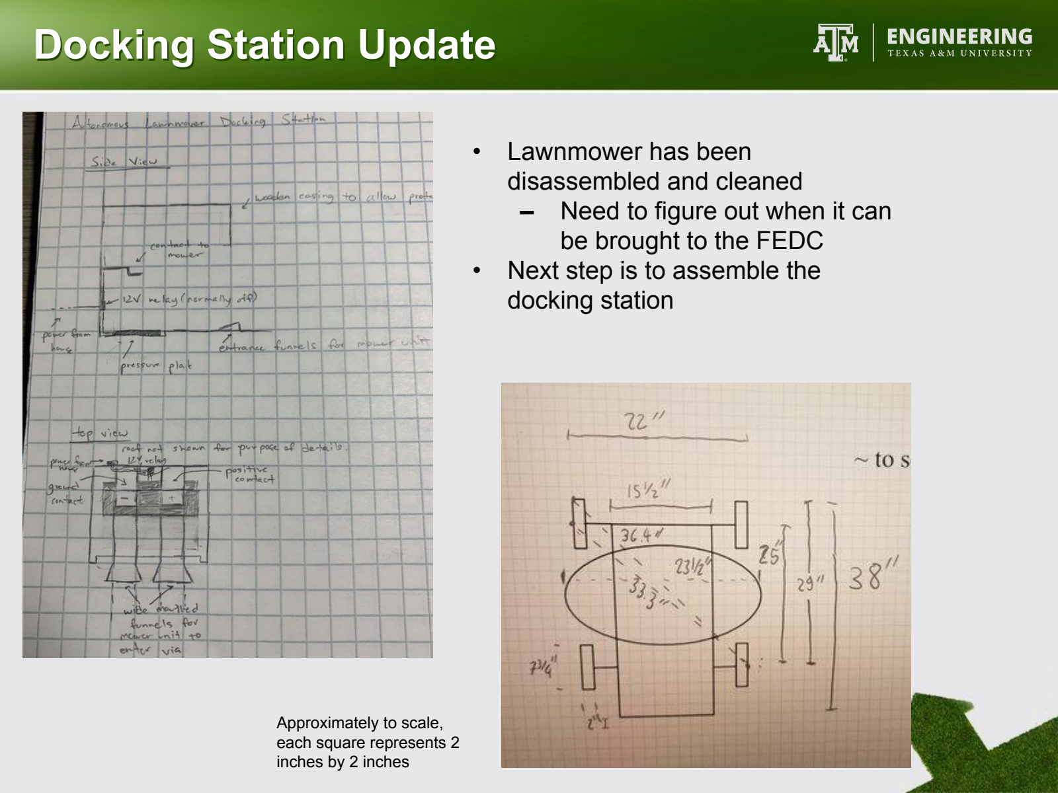
[picture p138: page 10]

### - Lawnmower has been disassembled and cleaned – Need to figure out when it can be brought to the FEDC - Next step is to assemble the docking station

Approximately to scale,
each square represents 2
inches by 2 inches

# Schedule for the Semester

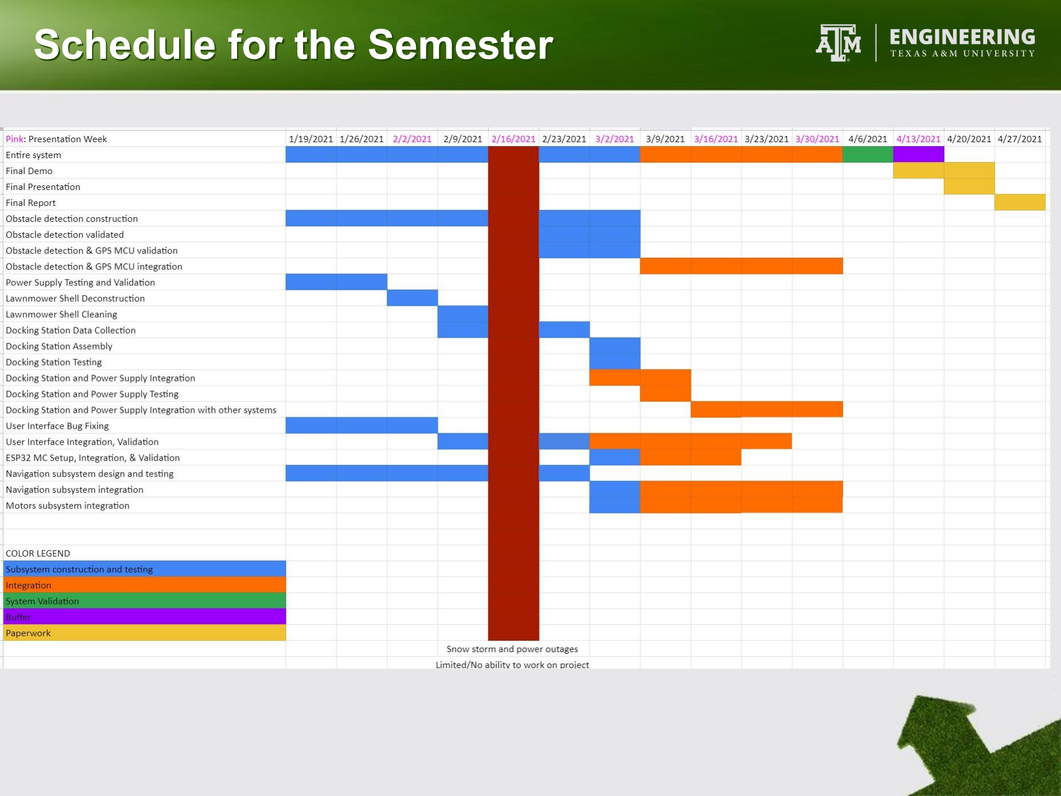
[picture p139: page 11]

# Validation Plan
