Lesser-M/ECEN404-Team-30--Autonomous-lawnmower/Presentations&Demos/Presentations/Biweekly Presentation 5.pdf

Autonomous Lawnmower; Max Lesser, Vincent McMasters, Josh Samaniego, Jonathan Poulose ECEN 404-904 Team 30

# Project Summary

### Problem Statement: “You will start with a lawn mower shell, add motors to propel the wheels, microcontroller to control everything, comms to a wifi network where area to be covered and route will be entered, and a power mechanism (docking station or other)”

- Use lawn mower body and reconfigure for our needs
- Electric motors for wheel and blade
- Solar and grid tied charging
- Docking station
- Navigate autonomously using various sensors
- Receive user information about area to mow and scheduling through app

# Integration Problems

- Front Sensor Array Errors
– Returns out of range value
– Array tested and works on Bench, so likely connection issue – Solution: Troubleshoot array connections one at a time
- Navigation Problems
– Insufficient torque for motors
- Doesn't allow for proper turns
- has issues moving on grass
- Solution: slow down mower to reduce momentum – Wheel problems
- Caster wheels not stable enough
- original wheels don’t allow for tight turns
- Solution: Ordered Mecanum Wheels (pick up from Grainger tomorrow)

# Blade Drive

- Blade Detached for testing
- Need to transfer control to Nav-MCU, interface is “plug and play” ready

# Integration

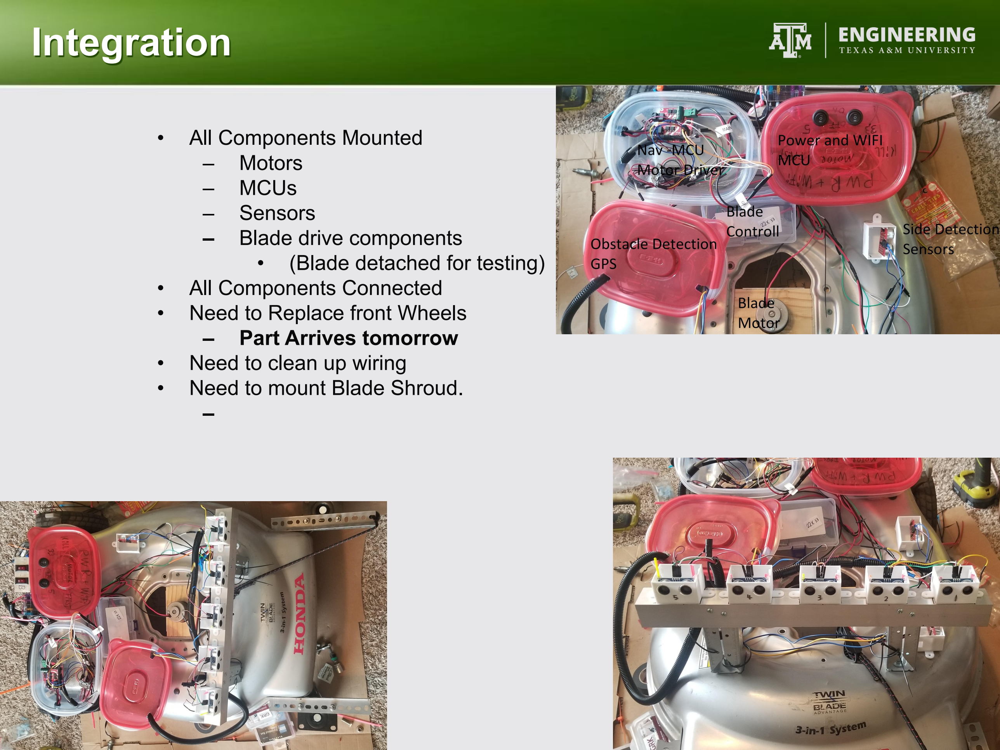
[picture p140: page 5]

- All Components Mounted
– | Motors
– | MCUs
– | Sensors
– | Blade drive components
| • (Blade detached for testing)
- All Components Connected
- Need to Replace front Wheels – Part Arrives tomorrow
- Need to clean up wiring
- Need to mount Blade Shroud. –

# User Interface/Server Update

# - Android application runs smoothly - Added stop button that corresponds with start status in server

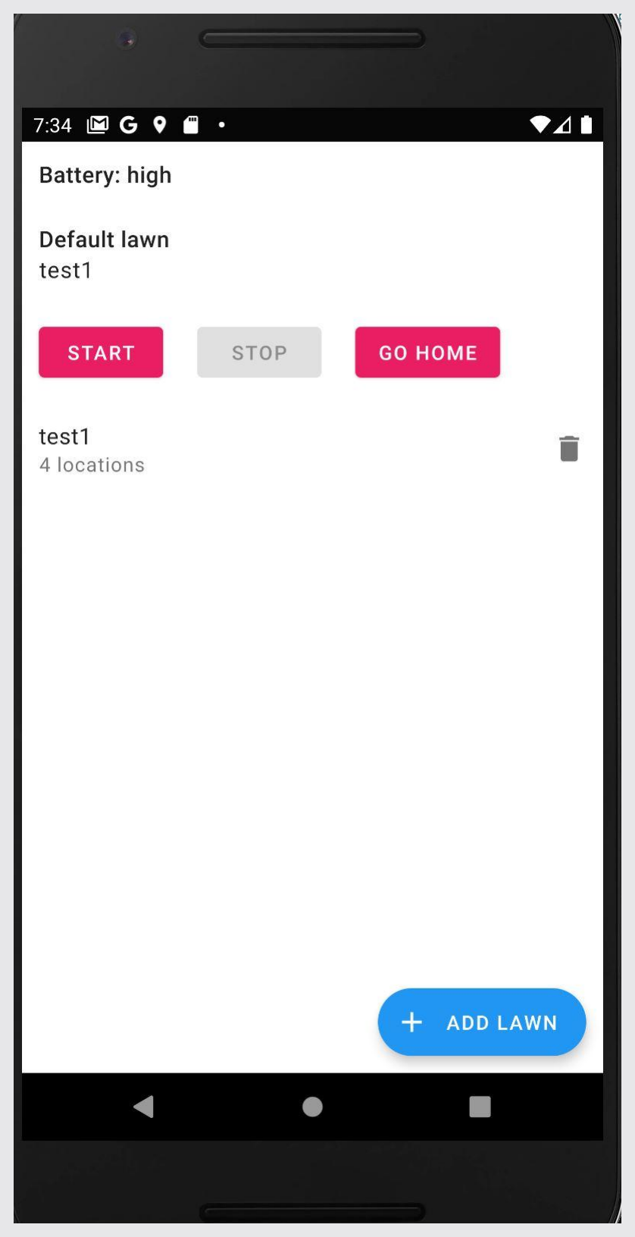
[picture p141: figure]
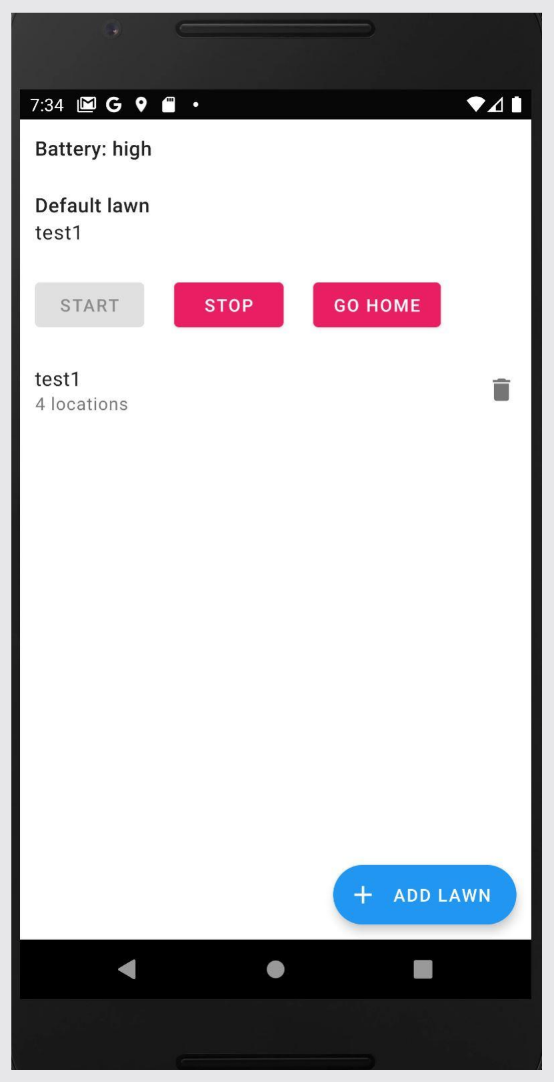
[picture p142: figure]

# - Android application

## – Can be used to turn on/off mower

# - Server with WiFi MCU integration

### – Communicating through WiFi

## – Server receives battery statistics from WiFi MCU & Nav MCU

### – WiFi MCU receives start_status and and coordinate information from server

# - WiFi MCU & Navigation MCU integration

## – Both MCU’s have been integrated – Bug has been fixed – Navigation code is still being worked on

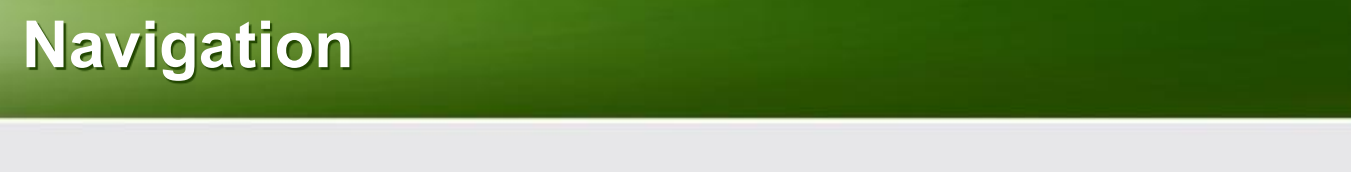
[picture p143: figure]
Navigation

## - This is our first mower test with the navigation code - We were able to make a rectangular pattern (somewhat) - Some directional issues occurred on the first leg - This is due to the unstable caster wheels in the front, new wheels have been purchased

# Schedule for the Semester

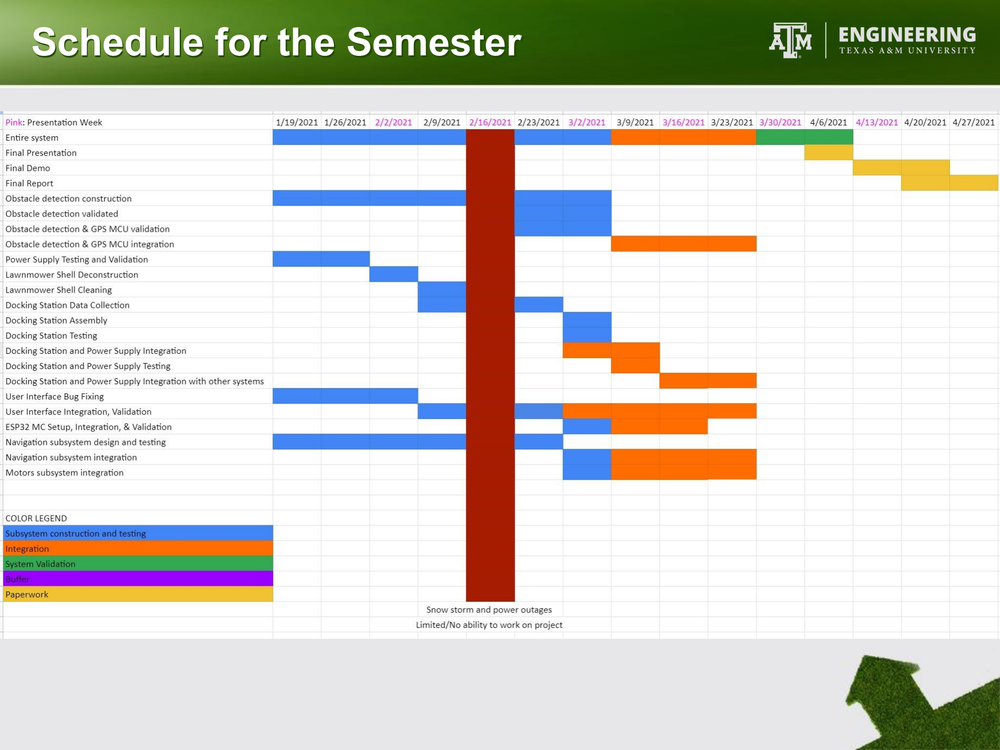
[picture p144: page 9]

# Validation Plan

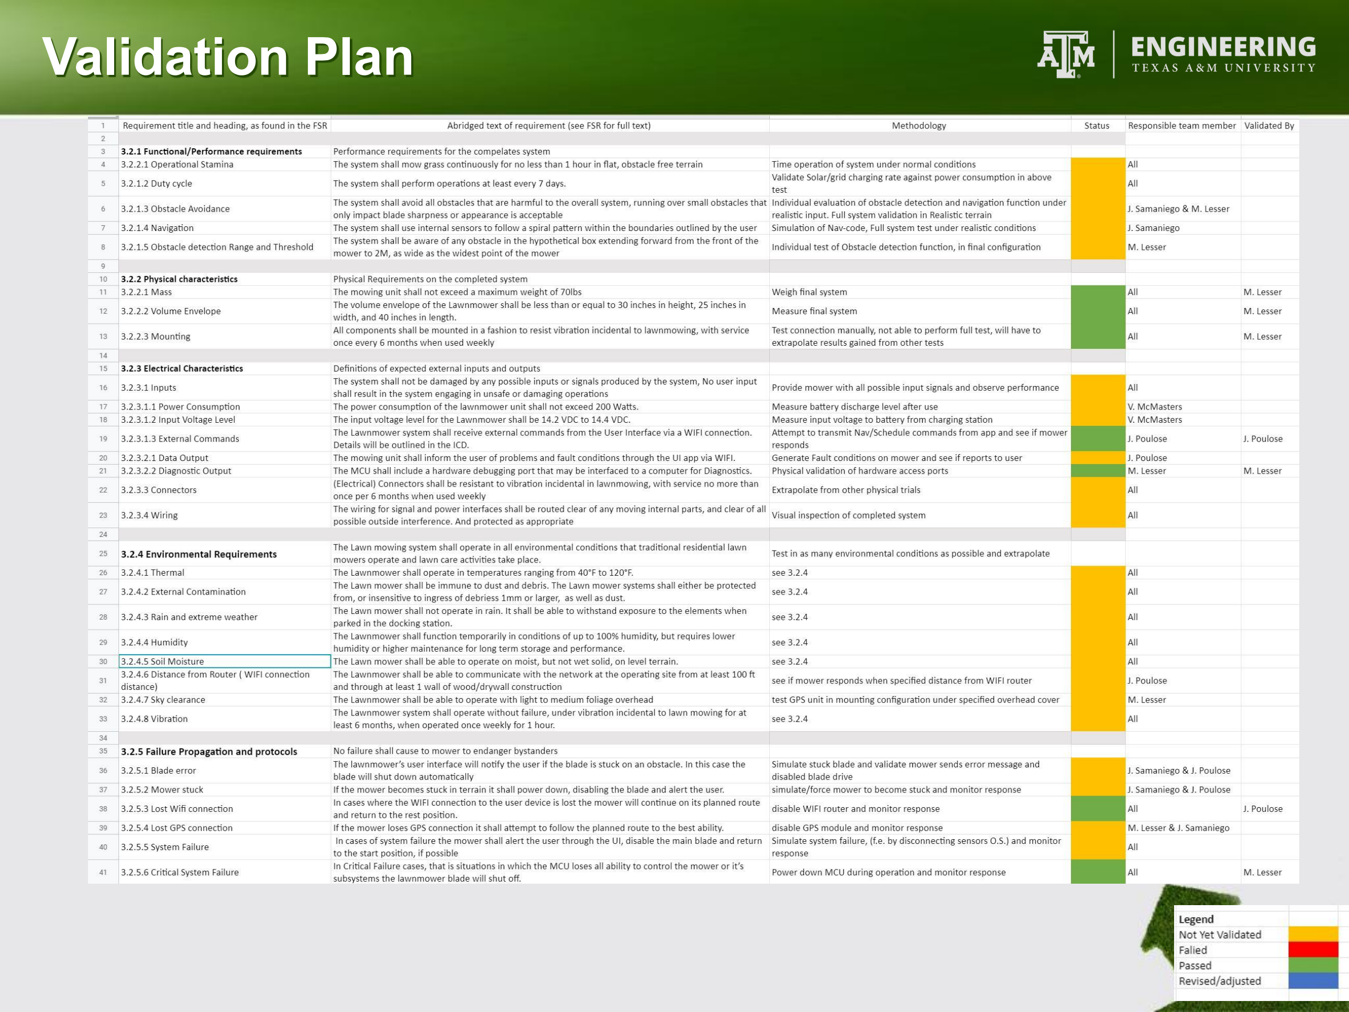
[picture p145: page 10]
