Lesser-M/ECEN404-Team-30--Autonomous-lawnmower/Reports-404/Individual Reports/1 Final Report Title Page and Table of Contents.pdf

## AUTONOMOUS LAWNMOWER

# Max Lesser Vincent McMasters Jonathan Poulose Josh Samaniego

# FINAL REPORT

### Table of Contents

Table of Contents | 2
Concept Of Operations (https://docs.google.com/document/d/1ZV3b6K9gcFFGPvDDktTtE4ZkPY6v2mpuYSeVlQhD2qI/edit) | 3
Interface Control Document (https://docs.google.com/document/d/1ZV3b6K9gcFFGPvDDktTtE4ZkPY6v2mpuYSeVlQhD2qI/edit) | 24
Functional Systems Requirement (https://docs.google.com/document/d/1ZV3b6K9gcFFGPvDDktTtE4ZkPY6v2mpuYSeVlQhD2qI/edit) | 46
Schedule (https://docs.google.com/document/d/1ZV3b6K9gcFFGPvDDktTtE4ZkPY6v2mpuYSeVlQhD2qI/edit) | 69
Validation Plan (https://docs.google.com/document/d/1ZV3b6K9gcFFGPvDDktTtE4ZkPY6v2mpuYSeVlQhD2qI/edit) | 73
Subsystem Reports (https://docs.google.com/document/d/1ZV3b6K9gcFFGPvDDktTtE4ZkPY6v2mpuYSeVlQhD2qI/edit) | 96
Power Supply Subsystem Report (https://docs.google.com/document/d/1ZV3b6K9gcFFGPvDDktTtE4ZkPY6v2mpuYSeVlQhD2qI/edit) | 98
MCU Subsystem Report (https://docs.google.com/document/d/1ZV3b6K9gcFFGPvDDktTtE4ZkPY6v2mpuYSeVlQhD2qI/edit) | 119
Motors Subsystem Report (https://docs.google.com/document/d/1ZV3b6K9gcFFGPvDDktTtE4ZkPY6v2mpuYSeVlQhD2qI/edit) | 152
User Interface Subsystem Report (https://docs.google.com/document/d/1ZV3b6K9gcFFGPvDDktTtE4ZkPY6v2mpuYSeVlQhD2qI/edit) | 163
