Lesser-M/ECEN404-Team-30--Autonomous-lawnmower/Reports-404/Individual Reports/5-1 Schedule Title Page.pdf

### Autonomous Lawnmower

Max Lesser
Vincent McMasters
Josh Samaniego
Jonathan Poulose

SCHEDULE

REVISION – FINAL
24 April 2021
