Lesser-M/ECEN404-Team-30--Autonomous-lawnmower/Presentations&Demos/Validation Pics+Videos/README

Pictures and vidoes demonstrating system validation goes in here
