Lesser-M/ECEN404-Team-30--Autonomous-lawnmower/CodeDemoed/PIC-32/FULL-PIC-CODE/src/config/default/exceptions.c

/*******************************************************************************
  MPLAB Harmony Exceptions Source File

  File Name:
    exceptions.c

  Summary:
    This file contains a function which overrides the default _weak_ exception
    handler provided by the XC32 compiler.

  Description:
    This file redefines the default _weak_  exception handler with a more debug
    friendly one. If an unexpected exception occurs the code will stop in a
    while(1) loop.  The debugger can be halted and two variables _excep_code and
    _except_addr can be examined to determine the cause and address where the
    exception occurred.
 *******************************************************************************/

// DOM-IGNORE-BEGIN
/*******************************************************************************
* Copyright (C) 2018 Microchip Technology Inc. and its subsidiaries.
*
* Subject to your compliance with these terms, you may use Microchip software
* and any derivatives exclusively with Microchip products. It is your
* responsibility to comply with third party license terms applicable to your
* use of third party software (including open source software) that may
* accompany Microchip software.
*
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
* IN NO EVENT WILL MICROCHIP BE LIABLE FOR ANY INDIRECT, SPECIAL, PUNITIVE,
* INCIDENTAL OR CONSEQUENTIAL LOSS, DAMAGE, COST OR EXPENSE OF ANY KIND
* WHATSOEVER RELATED TO THE SOFTWARE, HOWEVER CAUSED, EVEN IF MICROCHIP HAS
* BEEN ADVISED OF THE POSSIBILITY OR THE DAMAGES ARE FORESEEABLE. TO THE
* FULLEST EXTENT ALLOWED BY LAW, MICROCHIP'S TOTAL LIABILITY ON ALL CLAIMS IN
* ANY WAY RELATED TO THIS SOFTWARE WILL NOT EXCEED THE AMOUNT OF FEES, IF ANY,
* THAT YOU HAVE PAID DIRECTLY TO MICROCHIP FOR THIS SOFTWARE.
*******************************************************************************/
// DOM-IGNORE-END

// *****************************************************************************
// *****************************************************************************
// Section: Included Files
// *****************************************************************************
// *****************************************************************************
#include "definitions.h"
#include <stdio.h>

//
//// *****************************************************************************
//// *****************************************************************************
//// Section: Global Data Definitions
//// *****************************************************************************
//// *****************************************************************************
//
///*******************************************************************************
//  Exception Reason Data
//
//  <editor-fold defaultstate="expanded" desc="Exception Reason Data">
//
//  Remarks:
//    These global static items are used instead of local variables in the
//    _general_exception_handler function because the stack may not be available
//    if an exception has occured.
//*/
//
///* Address of instruction that caused the exception. */
//static unsigned int _excep_addr;
//
///* Enum identifying the cause */
//typedef enum {
//    EXCEP_IRQ      =  0, // interrupt
//    EXCEP_AdEL     =  4, // address error exception (load or ifetch)
//    EXCEP_AdES     =  5, // address error exception (store)
//    EXCEP_IBE      =  6, // bus error (ifetch)
//    EXCEP_DBE      =  7, // bus error (load/store)
//    EXCEP_Sys      =  8, // syscall
//    EXCEP_Bp       =  9, // breakpoint
//    EXCEP_RI       = 10, // reserved instruction
//    EXCEP_CpU      = 11, // coprocessor unusable
//    EXCEP_Overflow = 12, // arithmetic overflow
//    EXCEP_Trap     = 13, // trap (possible divide by zero)
//    EXCEP_IS1      = 16, // implementation specfic 1
//    EXCEP_CEU      = 17, // CorExtend Unuseable
//    EXCEP_C2E      = 18, // coprocessor 2
//} excep_code;
//
///* Code identifying the cause of the exception (CP0 Cause register). */
//static excep_code _excep_code;
//
//// </editor-fold>
//
///*******************************************************************************
//  Function:
//    void _general_exception_handler ( void )
//
//  Description:
//    A general exception is any non-interrupt exception which occurs during program
//    execution outside of bootstrap code.
//
//  Remarks:
//    Refer to the XC32 User's Guide for additional information.
// */
//
//void __attribute__((noreturn)) _general_exception_handler ( void )
//{
//    /* Mask off the ExcCode Field from the Cause Register
//    Refer to the MIPs Software User's manual */
//    _excep_code = (_CP0_GET_CAUSE() & 0x0000007C) >> 2;
//    _excep_addr = _CP0_GET_EPC();
//
//    while (1)
//    {
//        #if defined(__DEBUG) || defined(__DEBUG_D) && defined(__XC32)
//            __builtin_software_breakpoint();
//        #endif
//    }
//}
//
///*******************************************************************************
//  Function:
//    void _bootstrap_exception_handler ( void )
//
//  Description:
//    A bootstrap exception is any exception which occurs while bootstrap code is
//    running (STATUS.BEV bit is 1).
//
//  Remarks:
//    Refer to the XC32 User's Guide for additional information.
// */
 static enum {
      EXCEP_IRQ = 0,            // interrupt
      EXCEP_AdEL = 4,            // address error exception (load or ifetch)
      EXCEP_AdES,                // address error exception (store)
      EXCEP_IBE,                // bus error (ifetch)
      EXCEP_DBE,                // bus error (load/store)
      EXCEP_Sys,                // syscall
      EXCEP_Bp,                // breakpoint
      EXCEP_RI,                // reserved instruction
      EXCEP_CpU,                // coprocessor unusable
      EXCEP_Overflow,            // arithmetic overflow
      EXCEP_Trap,                // trap (possible divide by zero)
      EXCEP_IS1 = 16,            // implementation specfic 1
      EXCEP_CEU,                // CorExtend Unuseable
      EXCEP_C2E                // coprocessor 2
  } _excep_code;
  
  //static unsigned int _epc_code;
  static unsigned int _excep_addr;
  
  void _general_exception_handler(void)
  {
      asm volatile("mfc0 %0,$13" : "=r" (_excep_code));
      asm volatile("mfc0 %0,$14" : "=r" (_excep_addr));
  
      _excep_code = (_excep_code & 0x0000007C) >> 2;
      
      UART5_Write("\r\nGeneral Exception ",21);
      int EADR = _CP0_GET_EPC();
      char exep[8]; 
      itoa(exep, EADR, 16);
      UART5_Write(exep, 8); 
      
      switch(_excep_code){
        case EXCEP_IRQ: UART5_Write("interrupt",9);break;
        case EXCEP_AdEL: UART5_Write("address error exception (load or ifetch)",40);break;
        case EXCEP_AdES: UART5_Write("address error exception (store)",31);break;
        case EXCEP_IBE: UART5_Write("bus error (ifetch)",18);break;
        case EXCEP_DBE: UART5_Write("bus error (load/store)",22);break;
        case EXCEP_Sys: UART5_Write("syscall",7);break;
        case EXCEP_Bp: UART5_Write("breakpoint",10);break;
        case EXCEP_RI: UART5_Write("reserved instruction",21);break;
        case EXCEP_CpU: UART5_Write("coprocessor unusable",20);break;
        case EXCEP_Overflow: UART5_Write("arithmetic overflow",19);break;
        case EXCEP_Trap: UART5_Write("trap (possible divide by zero)",30);break;
        case EXCEP_IS1: UART5_Write("implementation specfic 1",24);break;
        case EXCEP_CEU: UART5_Write("CorExtend Unuseable",19);break;
        case EXCEP_C2E: UART5_Write("coprocessor 2",13);break;
      }
      UART5_Write(" at 0x",6);
      //UART5_Write(_excep_addr);
      UART5_Write("\r\n",2);
      //while (1) {
          // Examine _excep_code to identify the type of exception
          // Examine _excep_addr to find the address that caused the exception
      //}
  }

void __attribute__((noreturn)) _bootstrap_exception_handler(void)
{
    /* Mask off the ExcCode Field from the Cause Register
    Refer to the MIPs Software User's manual */
    _excep_code = (_CP0_GET_CAUSE() & 0x0000007C) >> 2;
    _excep_addr = _CP0_GET_EPC();

    while (1)
    {
        #if defined(__DEBUG) || defined(__DEBUG_D) && defined(__XC32)
            __builtin_software_breakpoint();
        #endif
    }
}
/*******************************************************************************
  Function:
    void _cache_err_exception_handler ( void )

  Description:
    A cache-error exception occurs when an instruction or data reference detects
    a cache tag or data error. This exception is not maskable. To avoid
    disturbing the error in the cache array the exception vector is to an
    unmapped, uncached address. This exception is precise.

  Remarks:
    Refer to the XC32 User's Guide for additional information.
 */

void __attribute__((noreturn)) _cache_err_exception_handler(void)
{
    /* Mask off the ExcCode Field from the Cause Register
    Refer to the MIPs Software User's manual */
    _excep_code = (_CP0_GET_CAUSE() & 0x0000007C) >> 2;
    _excep_addr = _CP0_GET_EPC();

    while (1)
    {
        #if defined(__DEBUG) || defined(__DEBUG_D) && defined(__XC32)
            __builtin_software_breakpoint();
        #endif
    }
}

/*******************************************************************************
  Function:
    void _simple_tlb_refill_exception_handler ( void )

  Description:
    During an instruction fetch or data access, a TLB refill exception occurs
    when no TLB entry matches a reference to a mapped address space and the EXL
    bit is 0 in the Status register. Note that this is distinct from the case
    in which an entry matches, but has the valid bit off. In that case, a TLB
    Invalid exception occurs.

  Remarks:
    Refer to the XC32 User's Guide for additional information.
 */

void __attribute__((noreturn)) _simple_tlb_refill_exception_handler(void)
{
    /* Mask off the ExcCode Field from the Cause Register
    Refer to the MIPs Software User's manual */
    _excep_code = (_CP0_GET_CAUSE() & 0x0000007C) >> 2;
    _excep_addr = _CP0_GET_EPC();

    while (1)
    {
        #if defined(__DEBUG) || defined(__DEBUG_D) && defined(__XC32)
            __builtin_software_breakpoint();
        #endif
    }
}
/*******************************************************************************
 End of File
*/
