Lesser-M/ECEN404-Team-30--Autonomous-lawnmower/(commit log)

2021-01-31 Upload protoype for object detect
    code calcuates angles and distances to objects given sensor readings
    Developed on VSC, not yet implented in MPlab
2021-02-14 Object detection function
    Reads front sensor array and processes readings into (normal distance, normal angle ) output format. Lightly tested
2021-03-02 Current version
    simplified front detect function, includes some safeties
    running at 7:30, releasing rest caused GPS to lose fix, otherwise works
    obstacle detection works,
    GPS worked at last state and was not changed
    [ObjectDetect.c, ObjectDetect.h, main.c, sensor_read.c, sensor_read.h]
2021-04-12 Basic Nav code V 2
    accepts outside dimensions of box to be mowed as variables in code. has option for course correction
    Intended to test mower maneuvering ability.
    Modified from initial version to account for incorrect behavior. Includes updated turn and stop functions primarily. as well as option for course correction
    NOT TESTED ON HARDWARE
    [NAV_CODE_Lesser_edit_2.ino]
2021-04-12 Nav code with obstacle avoidance.
    1st version of nav code amended for basic obstacle evasion.
    NOTE STILL USES OLD NAV CODE
    nav functions ( go straight/ turn/ stop) need updated to account for current motors and hardware behavior
    see NAV_CODE_Lesser_edit2 for newer version
    NOT TESTED ON HW.
    [NAV_CODE_lesser_edit_ODET2.ino]
2021-04-18 Nav Code_Current Version
    Obsatcle detection, Gyro, GPS, nd Nav
2021-04-18 obstacle detection, current version (4/17/21, 2144)
2021-04-23 Create ESP32
2021-04-23 PIC-32 code As ran during demo
    Code here is the PIC-32 code that ran during demo, excluding device config files
2021-04-24 Code used to test Gyro and calculated heading
    Heading was very inaccurate, and gyro had problems on mower,
    [Accel_Gyro_compass_read_and_meassure.ino]
2021-04-24 Moved to correct place
    Had the wrong code in the wrong folder at first
    [WIFI_NAV_1_5.ino]
2021-04-24 moved to extra for now
    Not sure where we want this, but the code we used during demo is now in the correct folder
    [WIFI_NAV_1_5.ino]
