Lesser-M/ECEN404-Team-30--Autonomous-lawnmower/Presentations&Demos/Validation Pics+Videos/3.2.3.1.2 Validation Photo (Small Battery Output Voltage).JPG

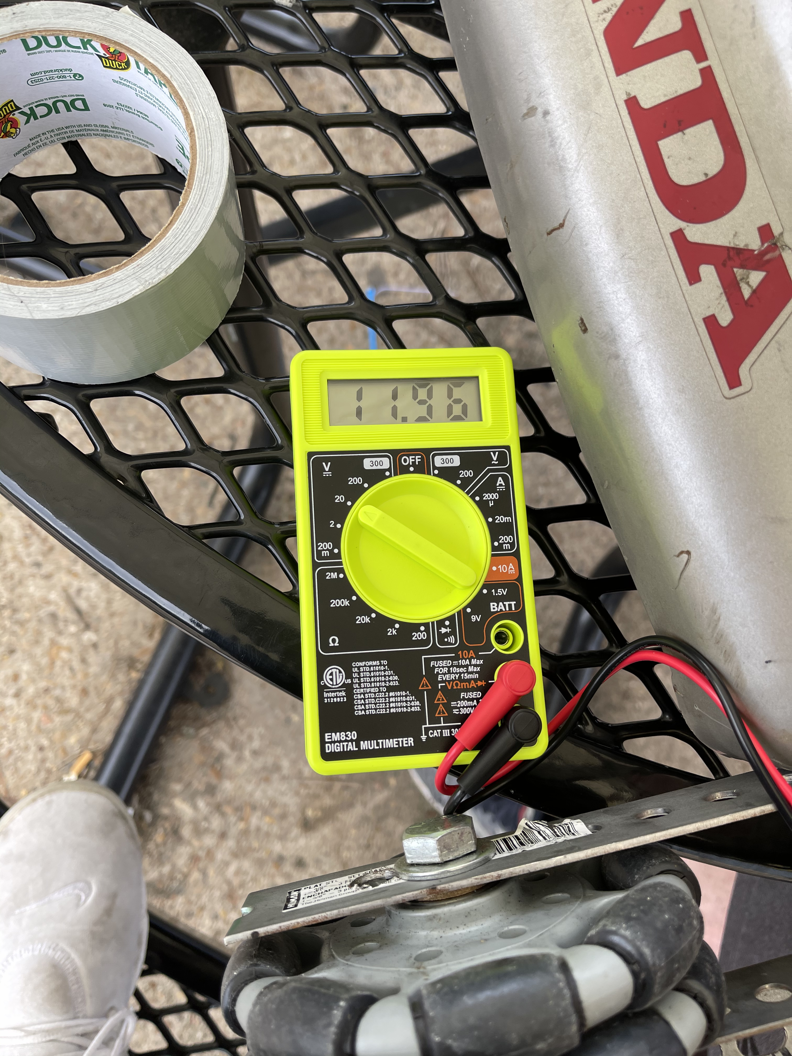
Presentations&Demos/Validation Pics+Videos/3.2.3.1.2 Validation Photo (Small Battery Output Voltage).JPG
