Lesser-M/ECEN404-Team-30--Autonomous-lawnmower/Presentations&Demos/Validation Pics+Videos/3.2.1.5 Validation Photo (Sensor Distance 3ft).JPG

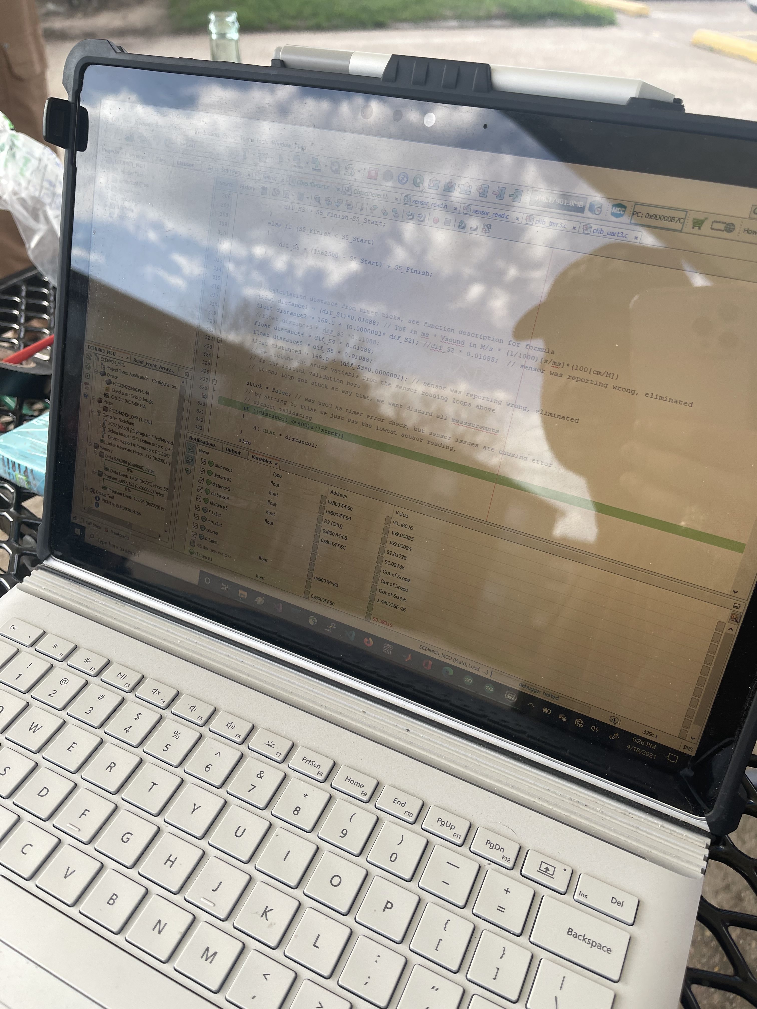
Presentations&Demos/Validation Pics+Videos/3.2.1.5 Validation Photo (Sensor Distance 3ft).JPG
